malachilandis2027/Dauber/BOM.xlsx

Sheet: Mechanical Parts
Part Number/Brand | Vendor | Quantity | Description | Function | Cost Per Unit | Total Cost | Link | Received?
HoCenWay | Amazon | 1 | 5mm bore GT2 80T pulley | Attached to the 775 motor | $11.99 | $11.99 | LINK (https://www.amazon.com/Pulley-Synchronous-Wheel-Timing-Printer/dp/B08JTS1DRK?s=hi) | Yes
MOCHU | Amazon | 4 | 17mm ID, 35mm OD, angular contact, ABEC-7, bearing 7003 | Spindle bearings | $12.80 | $51.20 | LINK (https://www.amazon.com/MOCHU-7003CTYNSULP4-17x35x10-Universal-Arrangement/dp/B074PV73YV) | Yes
XunLiu | Amazon | 1 | M3 x 75mm SHCS, 10 pack | Retain eccentric tube | $7.69 | $7.69 | LINK (https://www.amazon.com/XunLiu-Socket-Screws-Wrench-Knurled/dp/B07CHMDJ3F) | Yes
uxcell | Amazon | 1 | 5mm bore x 9mm OD x 6mm length bronze bushings 6 pack | Support idler wheel | $7.49 | $7.49 | LINK (https://www.amazon.com/uxcell-Bearing-Self-Lubricating-Sintered-Bushings/dp/B07JLXF7BT) | Yes
Associated Spring Raymond | Amazon | 1 | 8mm OD x 0.7mm free height x 357N belleville discs 10 pack | Preload idler wheel | $7.69 | $7.69 | LINK (https://www.amazon.com/Belleville-Spring-millimeters-Diameter-Compressed/dp/B005Y39KZE) | Yes
uxcell | Amazon | 1 | 3mm x 30mm dowel pins 10 pack | Locate idler wheel | $5.99 | $5.99 | LINK (https://www.amazon.com/uxcell-Straight-Retaining-Stainless-Elements/dp/B01N942DIY) | Yes
uxcell | Amazon | 1 | 5mm x 20mm dowel pins 10 pack | Idler wheel shaft | $8.99 | $8.99 | LINK (https://www.amazon.com/uxcell-Stainless-Cylindrical-Support-Elements/dp/B07Y58N9Z6) | Yes
PGN | Amazon | 1 | 15mm ID, 32mm OD, bearing 6002 | Drive wheel bearing | $6.45 | $6.45 | LINK (https://www.amazon.com/PGN-6002-2RS-Sealed-Ball-Bearing/dp/B07GVR3S7K) | Yes
priaolker | Amazon | 1 | M4 x 6mm set screw, 30 pack | Affix drive wheel to stepper | $5.99 | $5.99 | LINK (https://www.amazon.com/Stainless-Socket-Screws-Hexagon-Headless/dp/B0B392V6CX) | Yes
uxcell | Amazon | 1 | M8 x 20mm set screw, ball tip, 30 pack | Preload idler wheel | $8.99 | $8.99 | LINK (https://www.amazon.com/uxcell-Screws-Carbon-Metric-Spring/dp/B0B4DF6PTM) | Yes
It Works Great | Amazon | 1 | M3 x 6mm BHCS, 100 pack | Retain drive wheel bearing | $7.99 | $7.99 | LINK (https://www.amazon.com/M3-0-5-Button-Socket-Screws-Finish/dp/B09G6L5D7B) | Yes
MewuDecor | Amazon | 1 | M5 x 12mm SHCS, 100 pack | Affix cap | $9.49 | $9.49 | LINK (https://www.amazon.com/Socket-Screws-Grade-Thread-Quantity/dp/B07NTYF2FZ) | Yes
uxcell | Amazon | 1 | M5 x 10mm x 1mm washers, 200 pack | Affix motor plate | $11.99 | $11.99 | LINK (https://www.amazon.com/uxcell-Plated-Washers-Spacers-Fastener/dp/B01NAB602N) | Yes
uxcell | Amazon | 1 | M6 x 6mm Pneumatic Fitting | Guide aluminum wire | $8.99 | $8.99 | LINK (https://www.amazon.com/uxcell-Straight-Pneumatic-Connect-Fittings/dp/B07Z9JYLMV) | Yes
CGELE | Amazon | 1 | 6mm OD x 4mm ID x 12m pneumatic tube | Guide aluminum wire | $11.99 | $11.99 | LINK (https://www.amazon.com/CGELE-Pneumatic-Tubing-39-4ft-Transfer/dp/B09JG5J24K) | Yes
MewuDecor | Amazon | 1 | M5 x 16mm SHCS, 50 pack | Affix motor plate | $8.89 | $8.89 | LINK (https://www.amazon.com/Socket-Screws-Grade-Alloy-Thread/dp/B0BLNLH7YY) | Yes
Generic | Amazon | 1 | 3mm x 12mm dowel pin 50 pack | Locate cap | $8.49 | $8.49 | LINK (https://www.amazon.com/3mm-12mm-Stainless-Support-Shelves/dp/B0BFRTZFCL) | Yes
RobotDigg | Amazon | 1 | GT2 260mm belt 10 pack | Connect 775 to spindle | $18.99 | $18.99 | LINK (https://www.amazon.com/RobotDigg-260-2gt-6-Endless-Length-Synchronous/dp/B07B5Y4MGZ) | Yes
HATCHBOX | Amazon | 1 | 1kg White PLA | Housings | $24.99 | $24.99 | LINK (https://www.amazon.com/HATCHBOX-3D-Filament-Dimensional-Accuracy/dp/B00J0GMMP6) | Yes
 |  |  |  |  |  | $0.00
 |  |  |  |  |  | $0.00
 |  |  |  |  |  | $0.00
 |  |  |  |  |  | $0.00
 |  |  |  |  |  | $0.00
 |  |  |  |  |  | $0.00
 |  |  |  |  |  | $0.00
 |  |  |  |  |  | $0.00
 |  |  |  |  |  | $0.00
 |  |  |  |  |  | $0.00
 |  |  |  |  |  | $0.00
 |  |  |  |  |  | $0.00
 |  |  |  |  |  | $0.00
 |  |  |  |  |  | $0.00
 |  |  |  |  |  | $0.00
 |  |  |  |  |  | $0.00
 |  |  |  |  |  | $0.00
 |  |  |  |  |  | $0.00
 |  |  |  |  |  | $0.00
 |  |  |  |  |  | $0.00
 |  |  |  |  |  | $0.00
 |  |  |  |  |  | $0.00
 |  |  |  |  |  | $0.00
Running Total: | $234.28

Sheet: Electrical Parts
Part Number/Brand | Vendor | Quantity | Description | Function | Cost Per Unit | Total Cost | Link | Received?
HiLetgo BTS7960 | Amazon | 1 | 43A High Power Motor Driver | Controls flow of power to the 775 main drive motor | $10.99 | $10.99 | LINK (https://www.amazon.com/HiLetgo-BTS7960-Driver-Arduino-Current/dp/B00WSN98DC?s=industrial) | Yes
CZH-LABS | Amazon | 1 | Screw Terminal Block for Arduino Nano | Breaks out the pins from the Arduino RP2040 Connect | $17.90 | $17.90 | LINK (https://www.amazon.com/CZH-LABS-Terminal-Breakout-Module-Arduino/dp/B07QMRDZ3W?s=industrial) | Yes
Meanwell LRS-350-24 | Amazon | 1 | 24V 14.6A Switchable Power Supply | Supplies power to the 775 and the stepper motor | $36.90 | $36.90 | LINK (https://www.amazon.com/MEAN-WELL-LRS-350-24-350-4W-Switchable/dp/B013ETVO12?s=industrial) | Yes
Stepperonline DM542T | Amazon | 1 | 1.0A-4.2A 20-50VDC Stepper Driver | Controls flow of power to the stepper on extruder | $21.99 | $21.99 | LINK (https://www.amazon.com/STEPPERONLINE-1-0-4-2A-20-50VDC-Micro-step-Resolutions/dp/B06Y5VPSFN) | Yes
Stepperonline | Amazon | 1 | 27:1 Nema 17 Stepper | Rotates the extruder wheels | $41.91 | $41.91 | LINK (https://www.amazon.com/27-Planetary-Gearbox-Stepper-Printer/dp/B00QEUZ9EM) | Yes
3Dman | Amazon | 1 | Power Socket | Power inlet from wall plug | $7.99 | $7.99 | LINK (https://www.amazon.com/3Dman-Rocker-Switch-Socket-C14-2pcs/dp/B07RRY5MYZ) | Yes
CERRXIAN | Amazon | 1 | Micro USB male to USB female | Takes the USB from the Arduino out to the panel | $8.79 | $8.79 | LINK (https://www.amazon.com/CERRXIAN-Female-Extension-Charge-Screws/dp/B07G4XYJ5W?s=industrial) | Yes
HiLetgo | Amazon | 1 | Logic level converter 10 pack | Shifts 3.3V to 5V for stepper controller | $7.49 | $7.49 | LINK (https://www.amazon.com/HiLetgo-Channels-Converter-Bi-Directional-3-3V-5V/dp/B07F7W91LC?s=industrial) | Yes
 |  |  |  |  |  | $0.00
 |  |  |  |  |  | $0.00
 |  |  |  |  |  | $0.00
 |  |  |  |  |  | $0.00
 |  |  |  |  |  | $0.00
 |  |  |  |  |  | $0.00
 |  |  |  |  |  | $0.00
 |  |  |  |  |  | $0.00
 |  |  |  |  |  | $0.00
 |  |  |  |  |  | $0.00
 |  |  |  |  |  | $0.00
 |  |  |  |  |  | $0.00
 |  |  |  |  |  | $0.00
 |  |  |  |  |  | $0.00
 |  |  |  |  |  | $0.00
 |  |  |  |  |  | $0.00
 |  |  |  |  |  | $0.00
 |  |  |  |  |  | $0.00
 |  |  |  |  |  | $0.00
 |  |  |  |  |  | $0.00
 |  |  |  |  |  | $0.00
 |  |  |  |  |  | $0.00
 |  |  |  |  |  | $0.00
 |  |  |  |  |  | $0.00
 |  |  |  |  |  | $0.00
 |  |  |  |  |  | $0.00
 |  |  |  |  |  | $0.00
 |  |  |  |  |  | $0.00
 |  |  |  |  |  | $0.00
 |  |  |  |  |  | $0.00
 |  |  |  |  |  | $0.00
 |  |  |  |  |  | $0.00
 |  |  |  |  |  | $0.00
 |  |  |  |  |  | $0.00
Running Total: | $153.96

Sheet: Machined Parts
Part Name | Quantity | Material |  | Quoted Price from Sinorise
Brazing Clamp 1 | 1 | Mild Steel |  | $25.00
Brazing Clamp 2 | 1 | Mild Steel |  | $25.00
Brazing Spacer | 1 | Mild Steel |  | $25.00
Cap | 1 | Carbon Steel |  | $25.00
Drive Wheel | 1 | Carbon Steel |  | $25.00
Eccentric Tube | 1 | Carbon Steel |  | $35.00
Fixed Shaft | 1 | Carbon Steel |  | $25.00
Idler Holder | 1 | Carbon Steel |  | $25.00
Idler Wheel | 1 | Carbon Steel |  | $25.00
Main Body | 1 | Carbon Steel |  | $85.00
Motor Plate | 1 | Mild Steel |  | $25.00
Nozzle | 1 | Carbon Steel |  | $30.00
Pulley Tube | 1 | Carbon Steel |  | $95.00
Retaining Ring | 1 | Carbon Steel |  | $25.00
Separation Ring | 1 | Carbon Steel |  | $25.00
Spacer Tube | 2 | Carbon Steel |  | $45.00
Wobble Shaft | 1 | Carbon Steel |  | $45.00
 |  |  | Total: | $610.00
