malachilandis2027/Dauber/CAD/Assemblies/Spindle Assembly.SLDASM

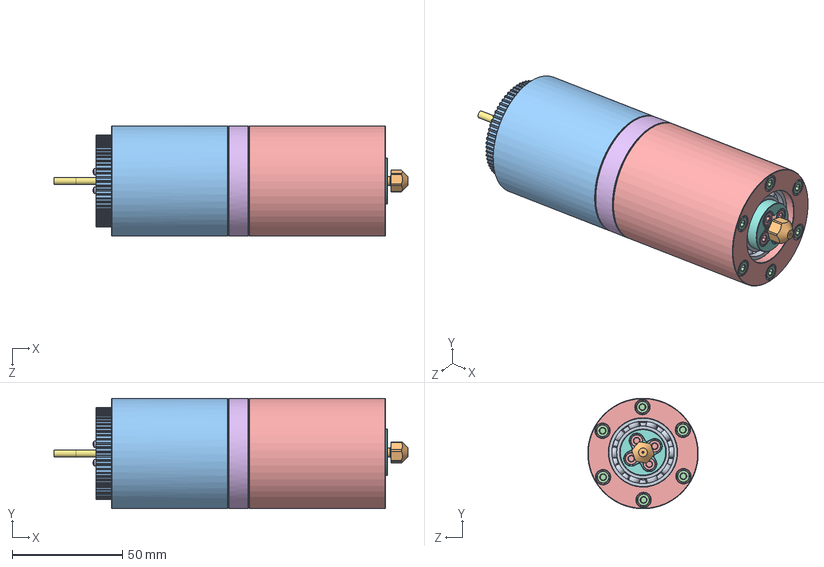
[picture p1: CAD file, 2023-07-06]
CAD/Assemblies/Spindle Assembly.SLDASM
160.2 x 50.0 x 50.0 mm
Fixed Shaft
Wobble Shaft
Pulley Tube
Spacer Tube x 2
Eccentric Tube
Separation Ring
Flexure Tube
Retaining Ring
7003 Angular Contact Bearing x 4
Nozzle
3mm x 20mm Dowel Pin x 2
M3 x 75mm x 6
M3 x 8mm SHCS x 4
3mm x 12mm Dowel Pin x 2
