malachilandis2027/Dauber/V2/CAD/V2 Assy.SLDASM

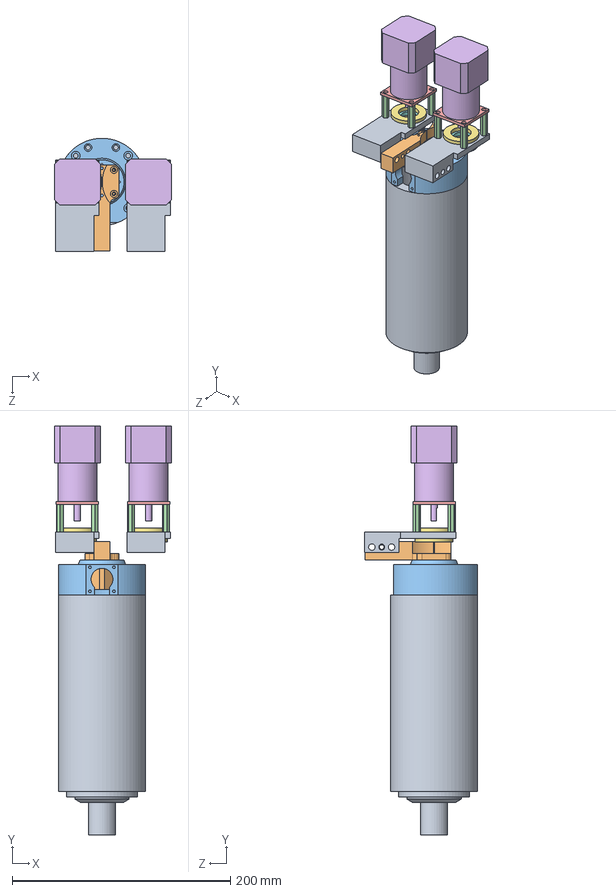
[picture p2: CAD file, 2024-10-05]
V2/CAD/V2 Assy.SLDASM
107.5 x 375.0 x 104.0 mm
Wire Guide
Motor Mount x 2
Feed Radial Bearing x 2
Feed Thrust Bearing x 4
Stepper x 2
Stepper Adapter Plate x 2
Hex Standoff M4 25mm x 8
Spindle Cap
Tube Holder Top
Spindle Body
