malachilandis2027/Dauber/V2/CAD/Rotating Assy.SLDASM

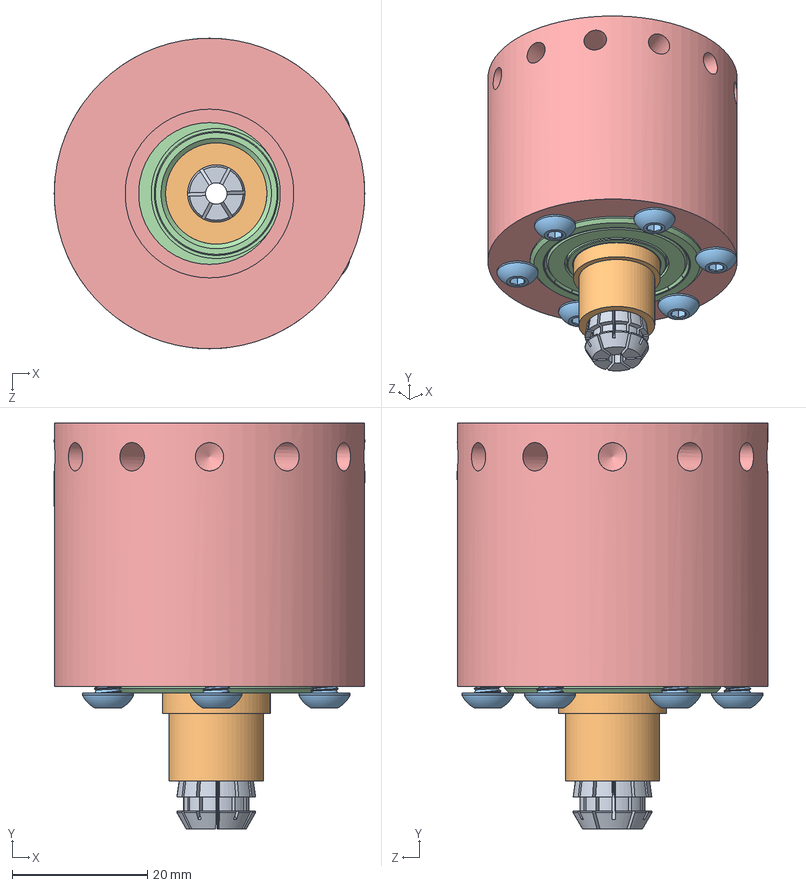
[picture p3: CAD file, 2024-03-31]
V2/CAD/Rotating Assy.SLDASM
46.0 x 60.1 x 46.0 mm
Rotating Bearing Block Straight
6002 Shielded Bearing x 2
M4 x 6mm BHCS x 6
ER11 Orbiting Collet
ER11 Collet 0.125in
