malachilandis2027/Dauber/V2/Buildplate/Lower Plate Top.DXF

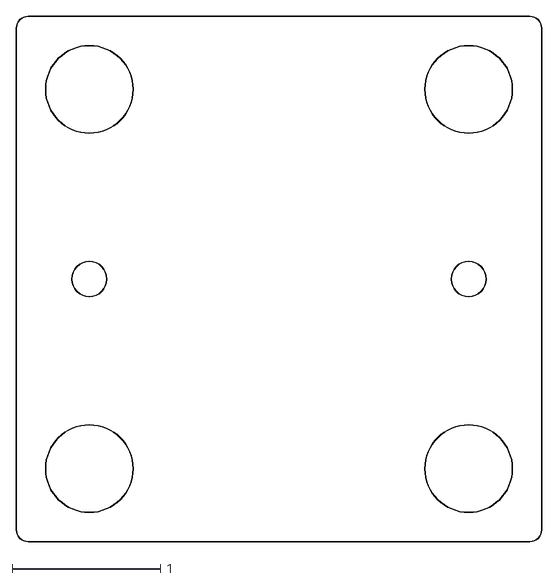
[picture p4: CAD file, 2025-02-11]
V2/Buildplate/Lower Plate Top.DXF
3.54 x 3.54
