malachilandis2027/Dauber/V2/CAD/Custom Parts/Feeder Spacer 1,0mm.STL

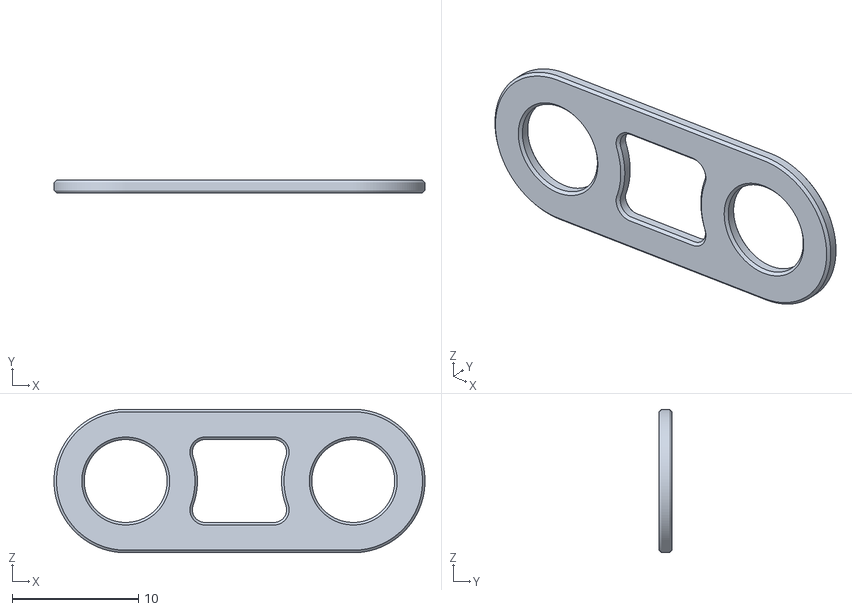
[picture p5: CAD file, 2025-01-28]
V2/CAD/Custom Parts/Feeder Spacer 1,0mm.STL
29.3 x 1.00 x 11.4
