malachilandis2027/Dauber/V2/CAD/Modified Parts/Spindle Cap.SLDPRT

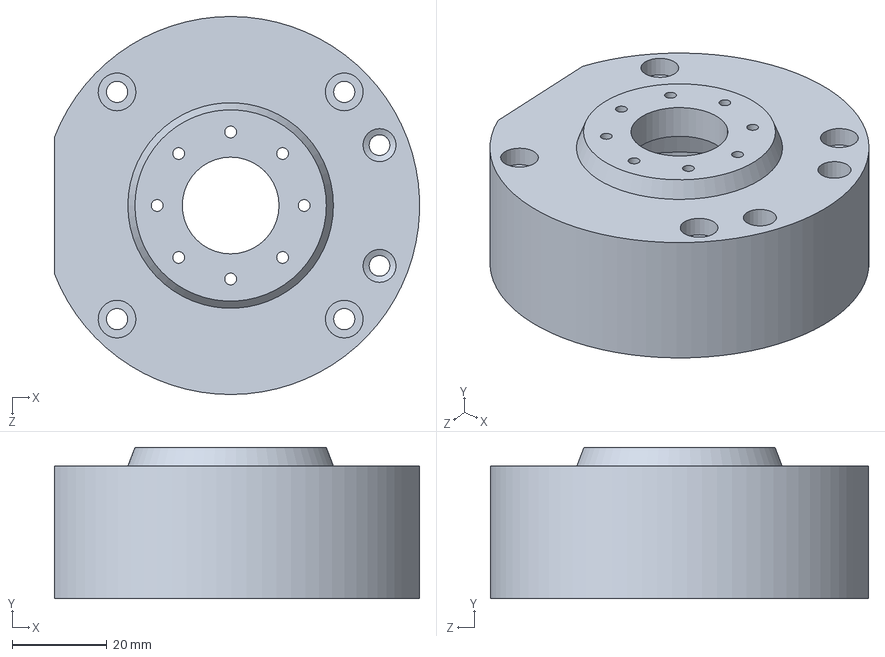
[picture p6: CAD file, 2024-09-06]
V2/CAD/Modified Parts/Spindle Cap.SLDPRT
77.2 x 32.0 x 80.0 mm
