malachilandis2027/Dauber/V2/CAD/Purchased Parts/Spindle Body.SLDPRT

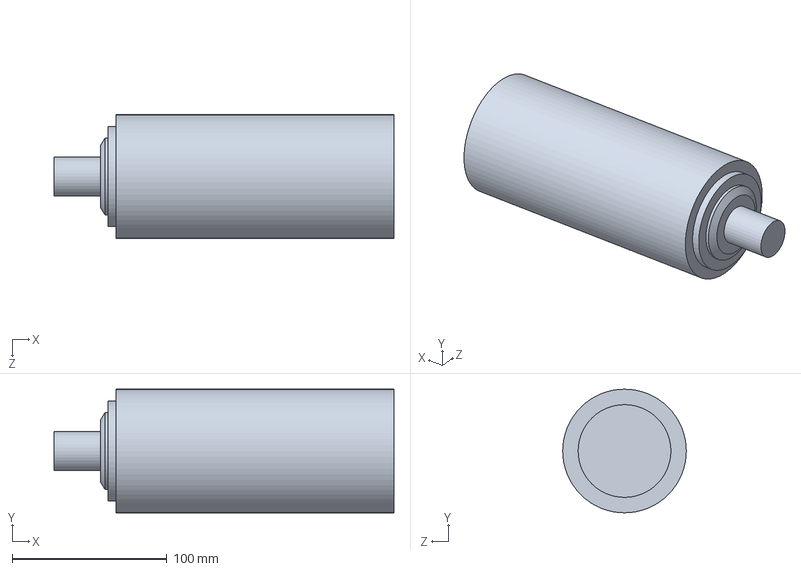
[picture p7: CAD file, 2024-09-06]
V2/CAD/Purchased Parts/Spindle Body.SLDPRT
220.0 x 80.0 x 80.0 mm
