malachilandis2027/Dauber/V2/Enclosure/Guide for Steppers PSU, Terminal Block.SLDPRT

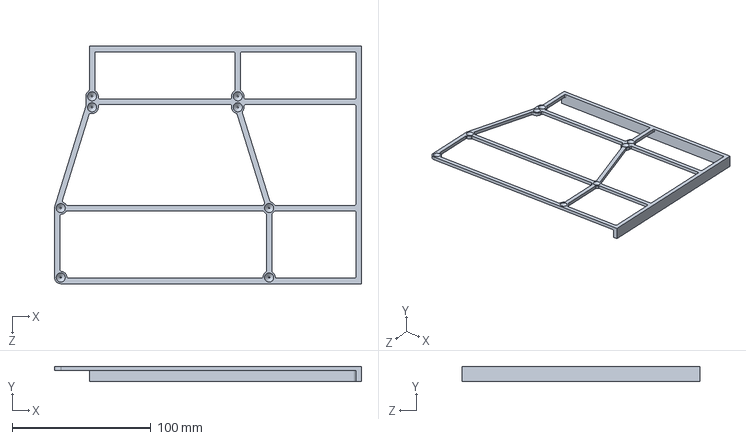
[picture p8: CAD file, 2025-01-21]
V2/Enclosure/Guide for Steppers PSU, Terminal Block.SLDPRT
221.0 x 11.0 x 171.0 mm
