malachilandis2027/Dauber/V2/Buildplate/Upper Plate Small.SLDPRT

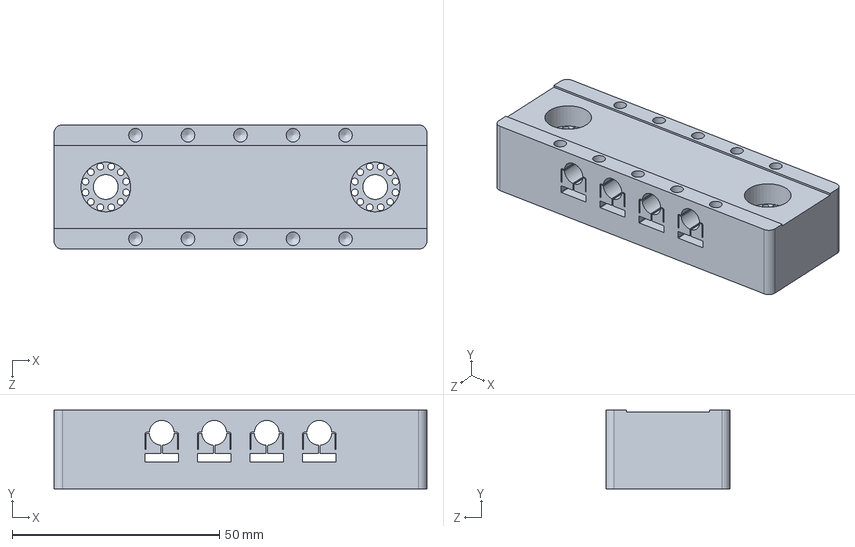
[picture p9: CAD file, 2025-02-11]
V2/Buildplate/Upper Plate Small.SLDPRT
90.0 x 19.1 x 30.0 mm
