malachilandis2027/Dauber/V2/CAD/Modified Parts/ER11 Orbiting Collet.SLDPRT

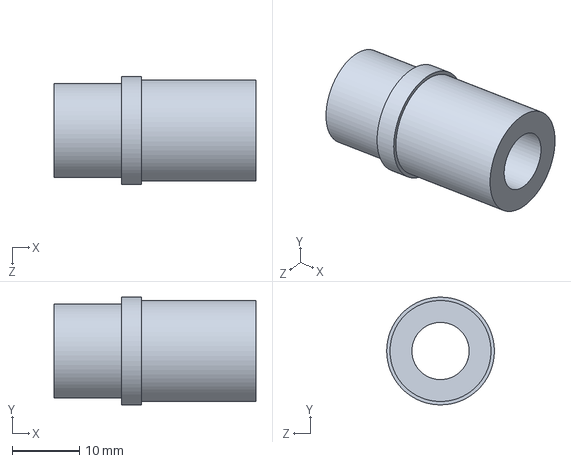
[picture p10: CAD file, 2024-03-31]
V2/CAD/Modified Parts/ER11 Orbiting Collet.SLDPRT
30.0 x 16.0 x 16.0 mm
