malachilandis2027/Dauber/V2/CAD/Purchased Parts/Hex Standoff M4 25mm.SLDPRT

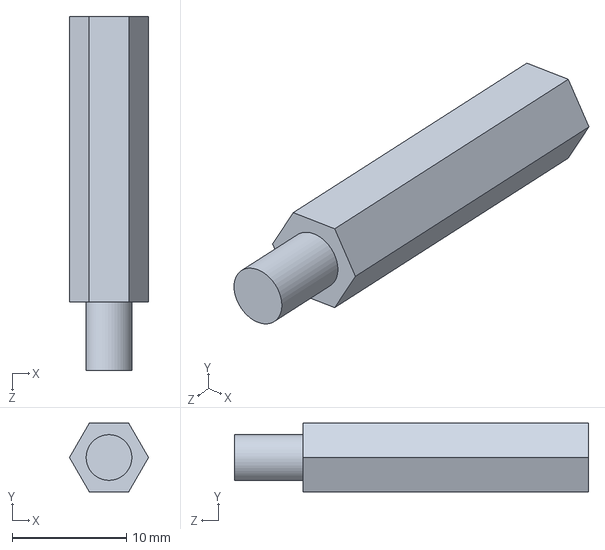
[picture p11: CAD file, 2024-09-06]
V2/CAD/Purchased Parts/Hex Standoff M4 25mm.SLDPRT
6.93 x 6.00 x 31.0 mm
