malachilandis2027/Dauber/V2/Enclosure/Top Panel.SLDPRT

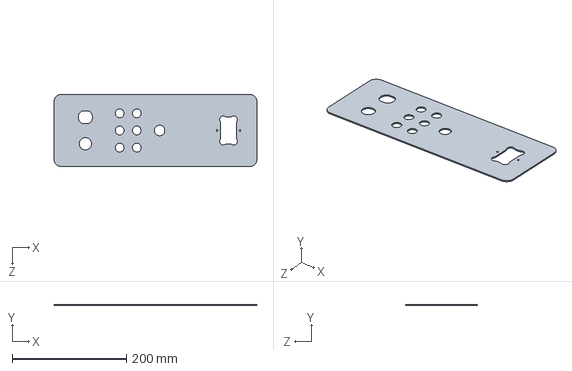
[picture p12: CAD file, 2025-01-21]
V2/Enclosure/Top Panel.SLDPRT
355.6 x 2.00 x 126.5 mm
