malachilandis2027/Dauber/V2/Buildplate/Upper Plate Underside.DXF

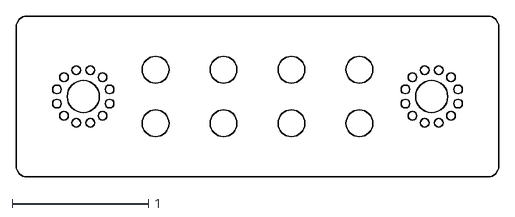
[picture p13: CAD file, 2025-02-11]
V2/Buildplate/Upper Plate Underside.DXF
3.54 x 1.18
