malachilandis2027/Dauber/V2/CAD/Purchased Parts/Feed Thrust Bearing.SLDPRT

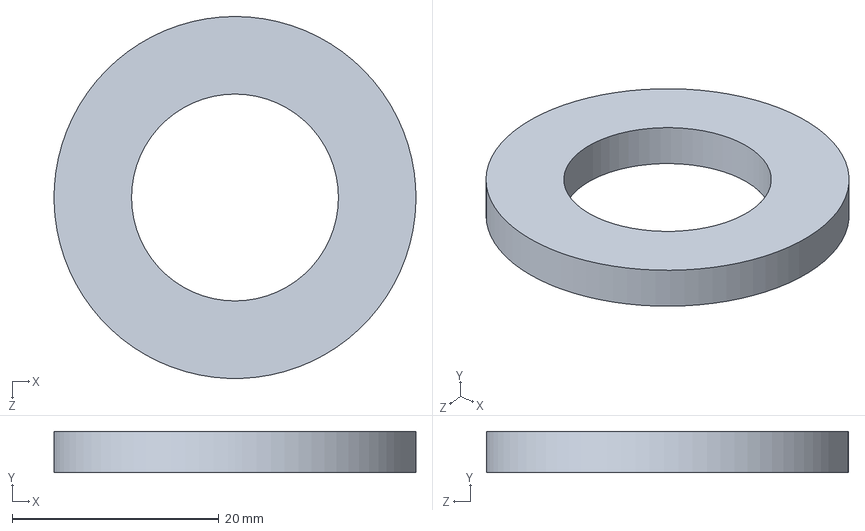
[picture p14: CAD file, 2024-09-06]
V2/CAD/Purchased Parts/Feed Thrust Bearing.SLDPRT
35.0 x 4.00 x 35.0 mm
