malachilandis2027/Dauber/V2/Enclosure/Guide for VFD, Acorn PSU.SLDPRT

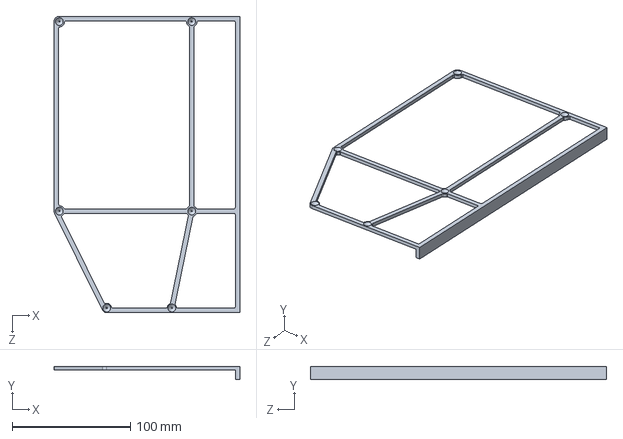
[picture p15: CAD file, 2025-01-21]
V2/Enclosure/Guide for VFD, Acorn PSU.SLDPRT
157.0 x 11.0 x 250.2 mm
