malachilandis2027/Dauber/V2/Buildplate/Upper Plate Side.DXF

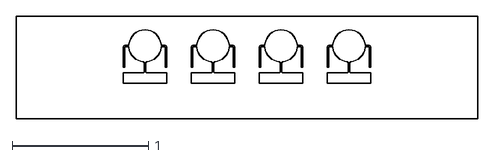
[picture p16: CAD file, 2025-02-11]
V2/Buildplate/Upper Plate Side.DXF
3.39 x 0.75
