malachilandis2027/Dauber/V2/CAD/Custom Parts/Feeder Spacer 1,2mm.STL

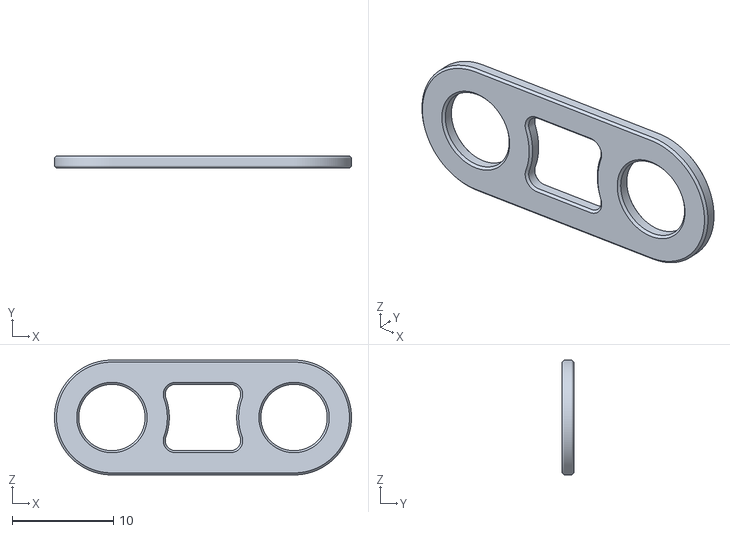
[picture p17: CAD file, 2025-01-28]
V2/CAD/Custom Parts/Feeder Spacer 1,2mm.STL
29.3 x 1.20 x 11.4
