malachilandis2027/Dauber/V2/CAD/Purchased Parts/Feed Radial Bearing.SLDPRT

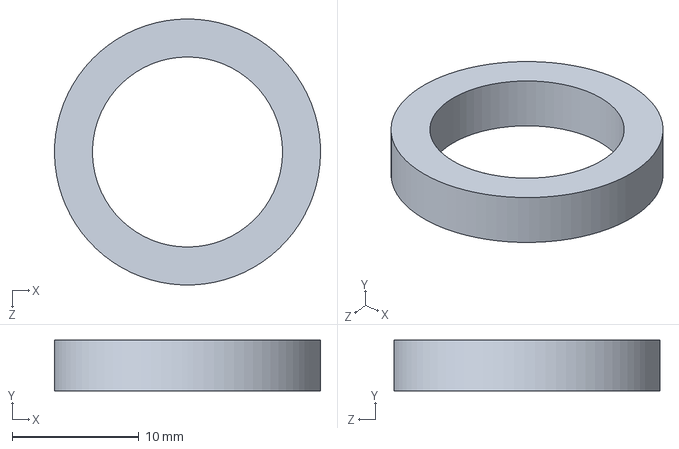
[picture p18: CAD file, 2024-09-06]
V2/CAD/Purchased Parts/Feed Radial Bearing.SLDPRT
21.0 x 4.00 x 21.0 mm
