malachilandis2027/Dauber/V2/Enclosure/Terminal Block.SLDPRT

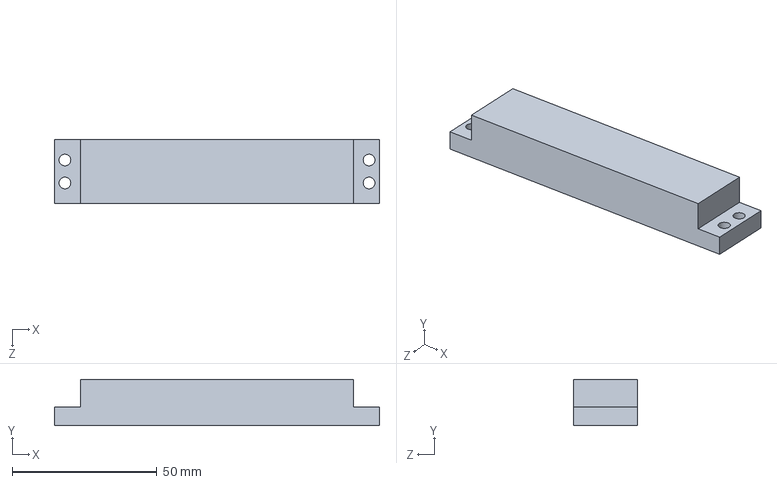
[picture p19: CAD file, 2025-01-21]
V2/Enclosure/Terminal Block.SLDPRT
112.1 x 16.0 x 22.0 mm
