malachilandis2027/Dauber/V2/Buildplate/Upper Plate.SLDPRT

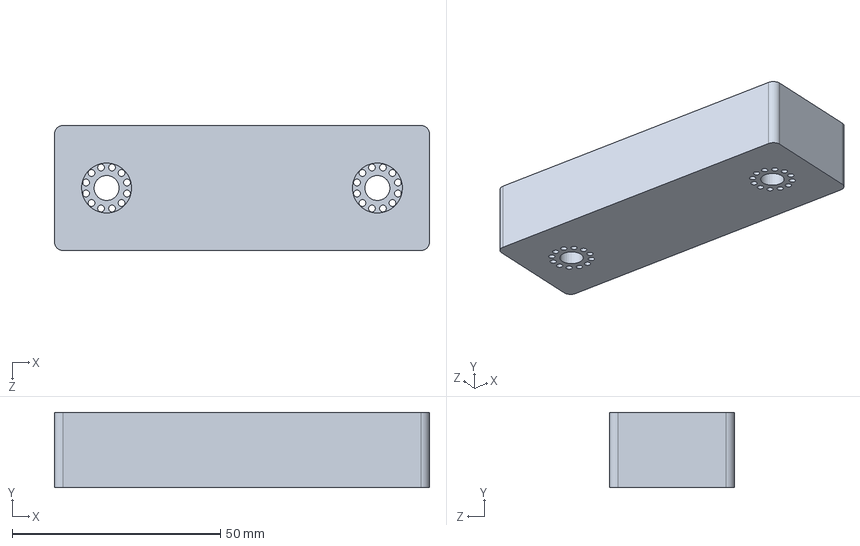
[picture p20: CAD file, 2025-02-11]
V2/Buildplate/Upper Plate.SLDPRT
90.0 x 18.0 x 30.0 mm
