malachilandis2027/Dauber/V2/CAD/Custom Parts/Feeder Spacer 0,8mm.STL

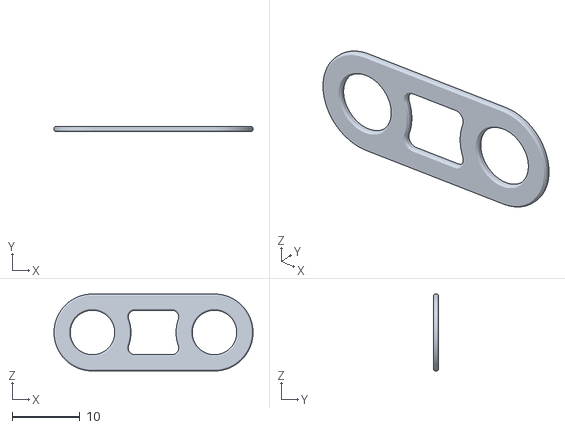
[picture p21: CAD file, 2025-01-28]
V2/CAD/Custom Parts/Feeder Spacer 0,8mm.STL
29.3 x 0.8 x 11.4
