malachilandis2027/Dauber/V2/CAD/Purchased Parts/Stepper.SLDPRT

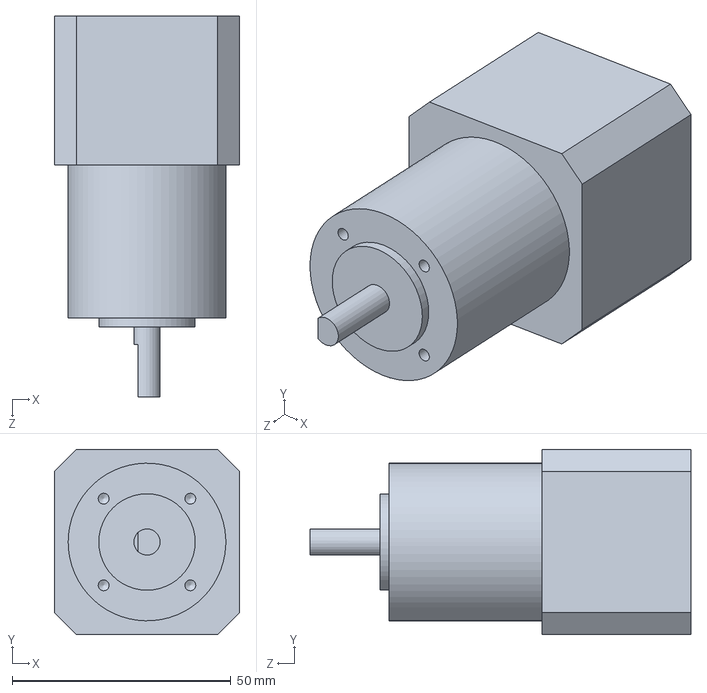
[picture p22: CAD file, 2024-09-06]
V2/CAD/Purchased Parts/Stepper.SLDPRT
42.3 x 42.3 x 87.0 mm
