malachilandis2027/Dauber/V2/Enclosure/Hole Spacer 1.SLDPRT

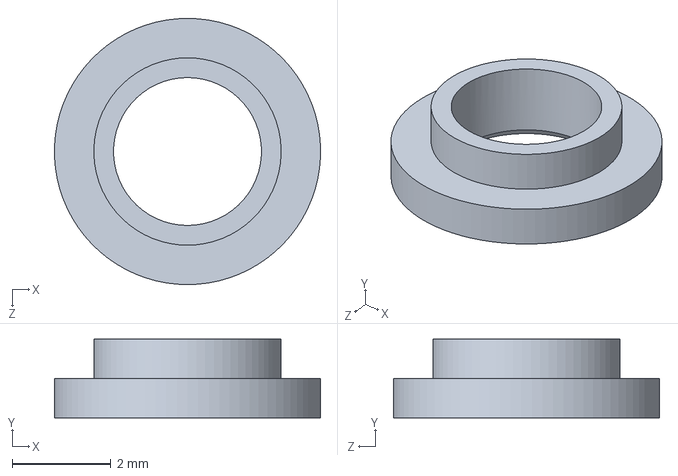
[picture p23: CAD file, 2025-01-21]
V2/Enclosure/Hole Spacer 1.SLDPRT
5.40 x 1.60 x 5.40 mm
