malachilandis2027/Dauber/V2/Buildplate/Upper Plate Large.SLDPRT

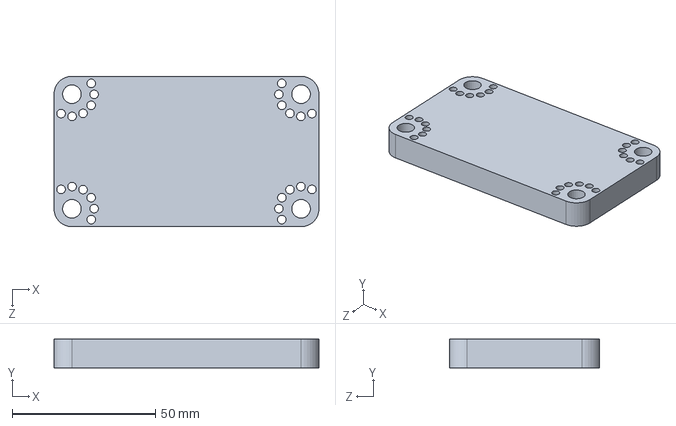
[picture p24: CAD file, 2025-02-11]
V2/Buildplate/Upper Plate Large.SLDPRT
92.5 x 10.0 x 52.5 mm
