malachilandis2027/Dauber/V2/CAD/Custom Parts/Feeder Spacer 1,4mm.STL

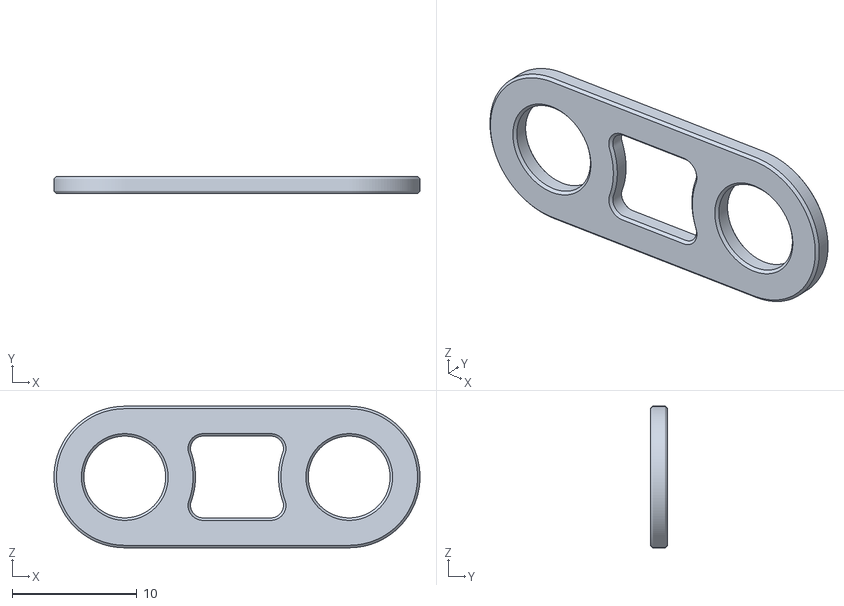
[picture p25: CAD file, 2025-01-28]
V2/CAD/Custom Parts/Feeder Spacer 1,4mm.STL
29.3 x 1.40 x 11.4
