malachilandis2027/Dauber/V2/CAD/Purchased Parts/ER11 Collet 0.125in.SLDPRT

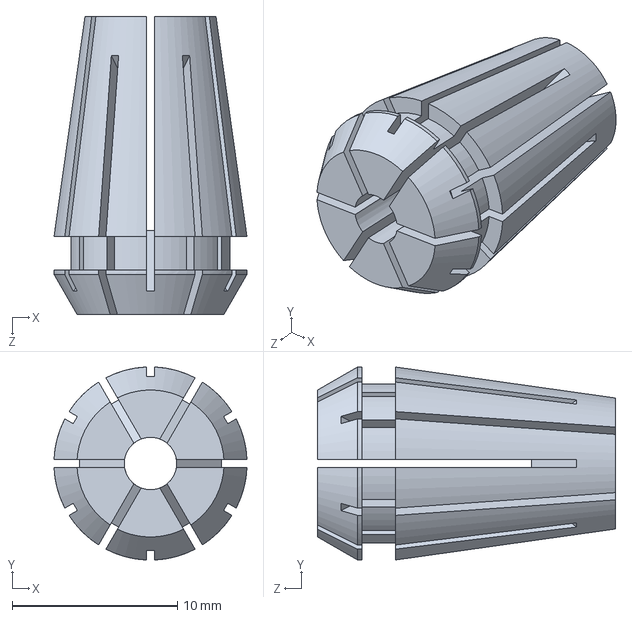
[picture p26: CAD file, 2024-03-31]
V2/CAD/Purchased Parts/ER11 Collet 0.125in.SLDPRT
11.7 x 11.7 x 18.0 mm
