malachilandis2027/Dauber/V2/Enclosure/Hole Spacer 2.SLDPRT

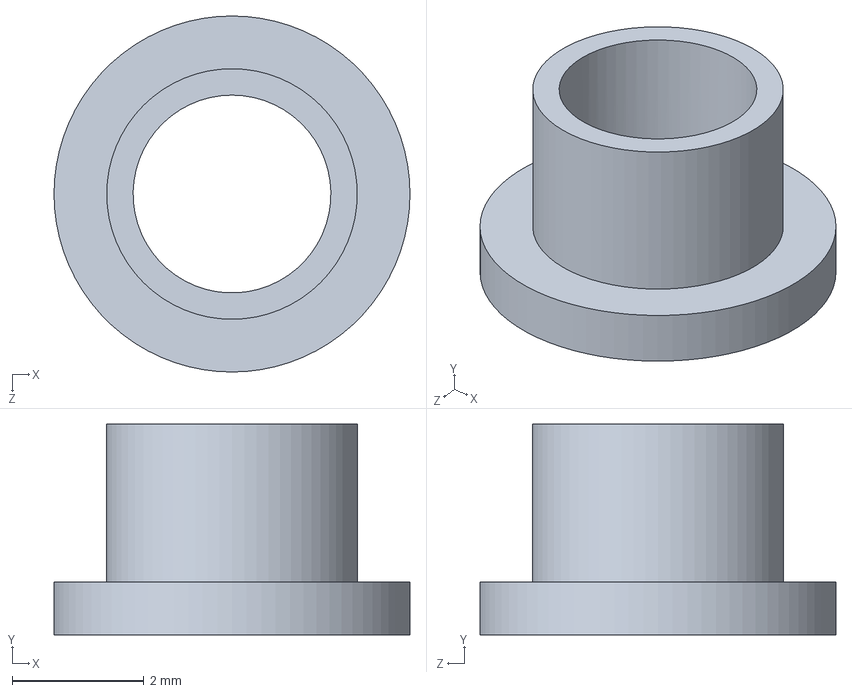
[picture p27: CAD file, 2025-01-21]
V2/Enclosure/Hole Spacer 2.SLDPRT
5.40 x 3.20 x 5.40 mm
