malachilandis2027/Dauber/V2/Buildplate/Lower Plate.SLDPRT

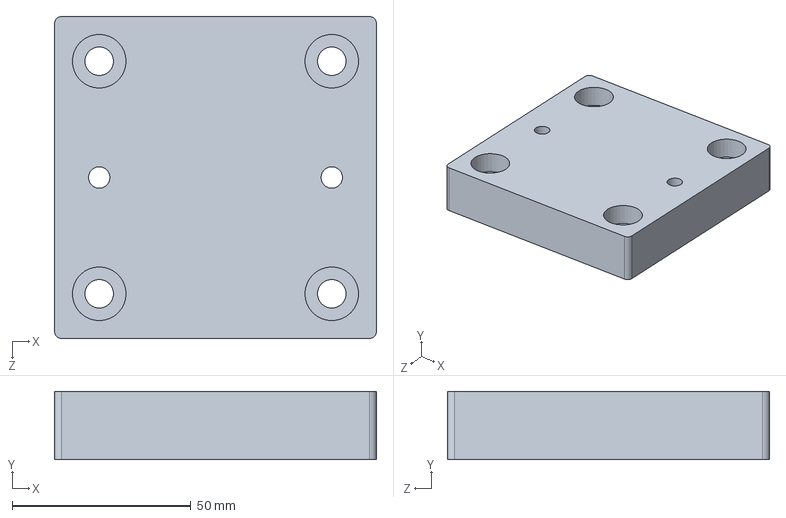
[picture p28: CAD file, 2025-02-11]
V2/Buildplate/Lower Plate.SLDPRT
90.0 x 19.1 x 90.0 mm
