malachilandis2027/Dauber/V2/CAD/Custom Parts/Wire Guide.SLDPRT

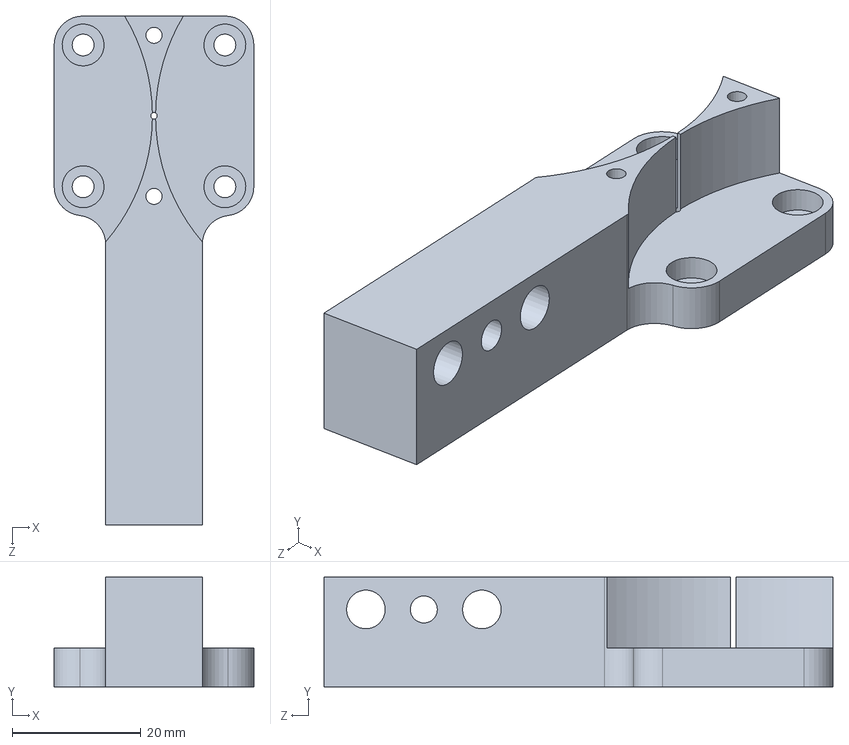
[picture p29: CAD file, 2024-10-05]
V2/CAD/Custom Parts/Wire Guide.SLDPRT
31.0 x 17.0 x 79.0 mm
