malachilandis2027/Dauber/V2/CAD/Purchased Parts/6002 Shielded Bearing.SLDPRT

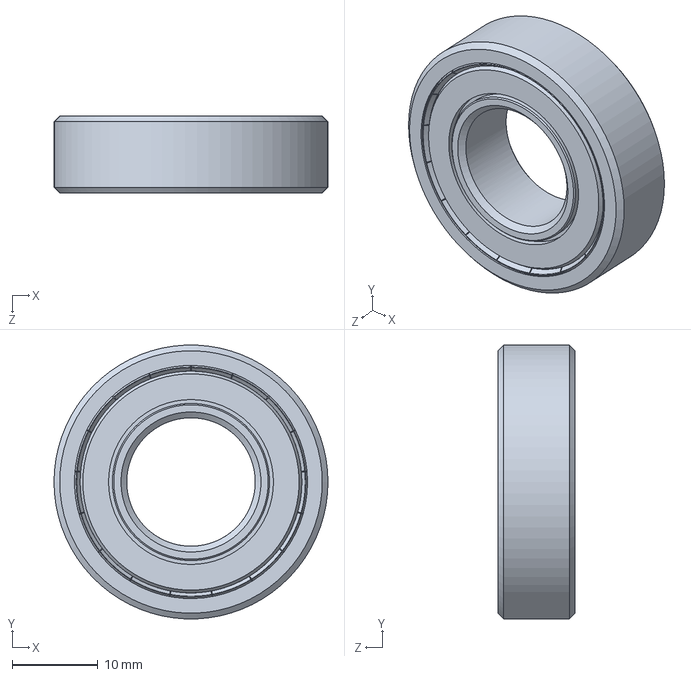
[picture p30: CAD file, 2024-03-31]
V2/CAD/Purchased Parts/6002 Shielded Bearing.SLDPRT
32.0 x 32.0 x 9.00 mm
