malachilandis2027/Dauber/V2/Enclosure/Back Panel.SLDPRT

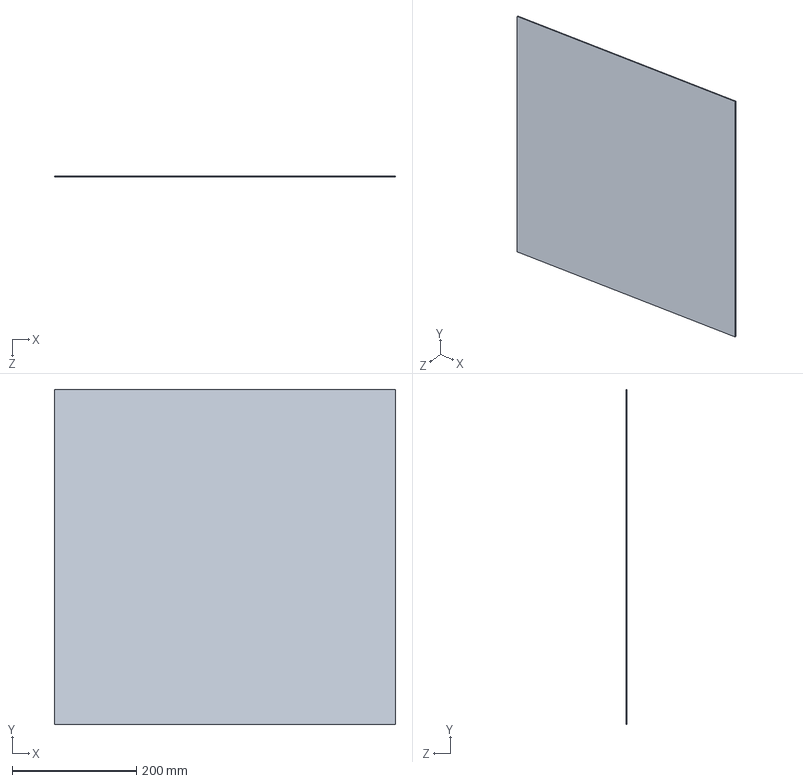
[picture p31: CAD file, 2025-01-21]
V2/Enclosure/Back Panel.SLDPRT
548.5 x 539.0 x 2.00 mm
