malachilandis2027/Dauber/V2/Enclosure/Terminal Block Riser.SLDPRT

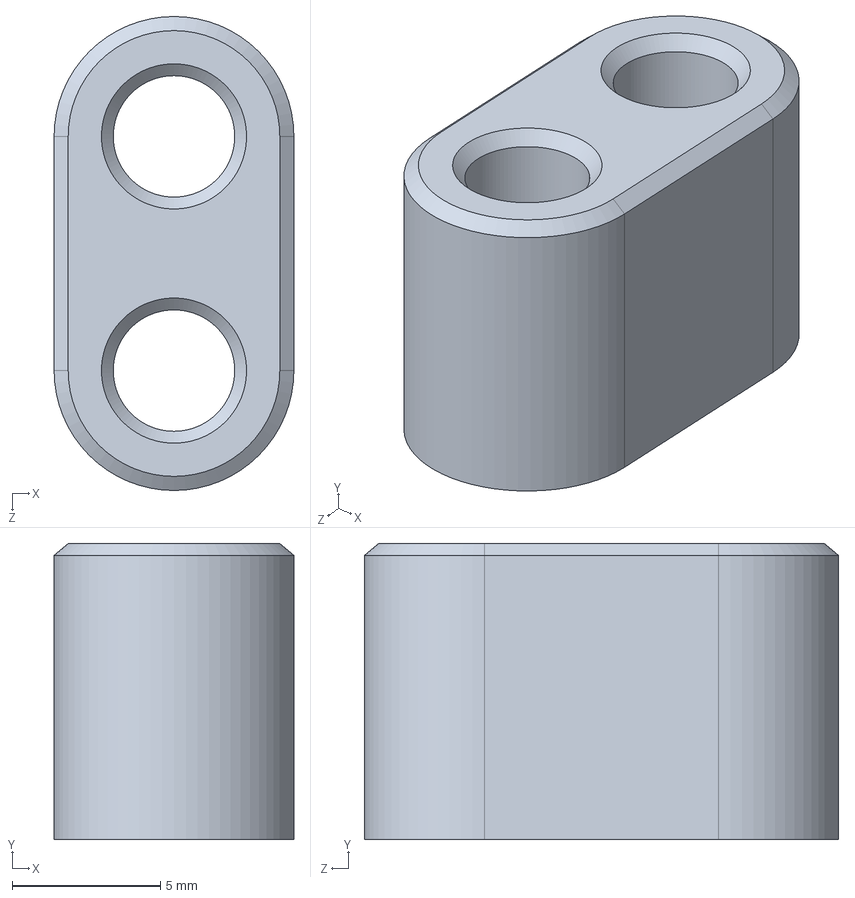
[picture p32: CAD file, 2025-01-21]
V2/Enclosure/Terminal Block Riser.SLDPRT
8.10 x 10.0 x 16.0 mm
