malachilandis2027/Dauber/V2/CAD/Custom Parts/Tube Holder Top.SLDPRT

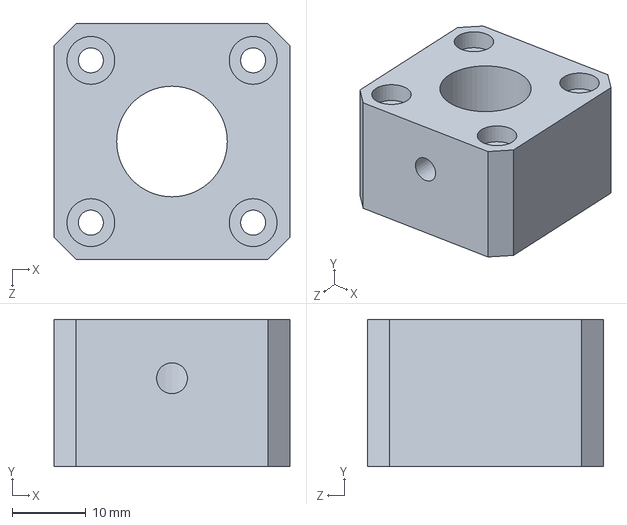
[picture p33: CAD file, 2024-09-06]
V2/CAD/Custom Parts/Tube Holder Top.SLDPRT
32.0 x 20.0 x 32.0 mm
