malachilandis2027/Dauber/V2/Enclosure/Guide for Acorn.SLDPRT

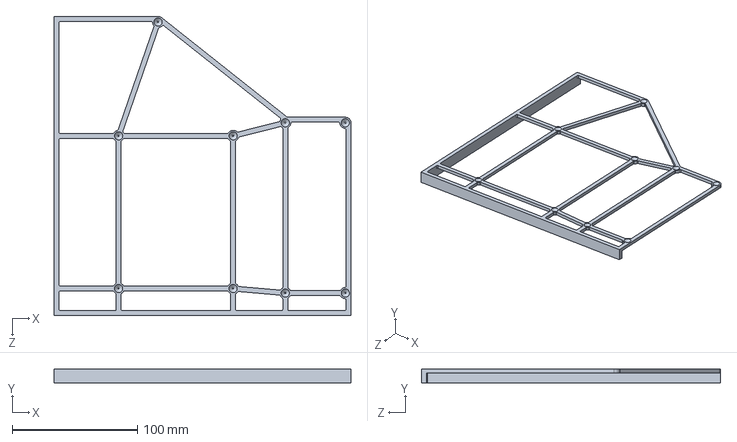
[picture p34: CAD file, 2025-01-21]
V2/Enclosure/Guide for Acorn.SLDPRT
237.2 x 11.0 x 239.0 mm
