malachilandis2027/Dauber/V2/CAD/Custom Parts/Stepper Adapter Plate.SLDPRT

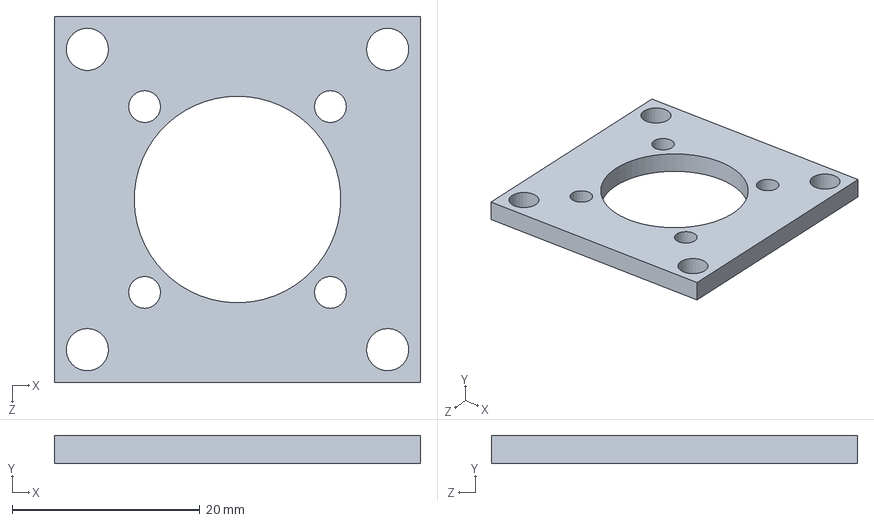
[picture p35: CAD file, 2024-09-06]
V2/CAD/Custom Parts/Stepper Adapter Plate.SLDPRT
39.0 x 3.00 x 39.0 mm
