malachilandis2027/Dauber/V2/CAD/Purchased Parts/M4 x 6mm BHCS.SLDPRT

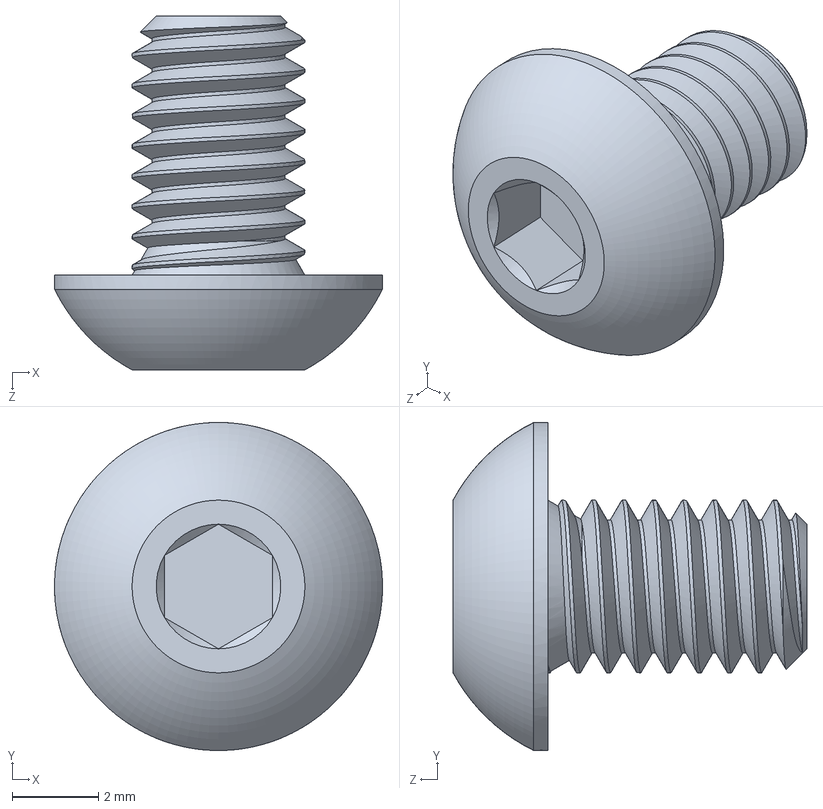
[picture p36: CAD file, 2024-03-31]
V2/CAD/Purchased Parts/M4 x 6mm BHCS.SLDPRT
7.60 x 7.60 x 8.20 mm
