malachilandis2027/Dauber/V2/Enclosure/Hole Spacer 3.SLDPRT

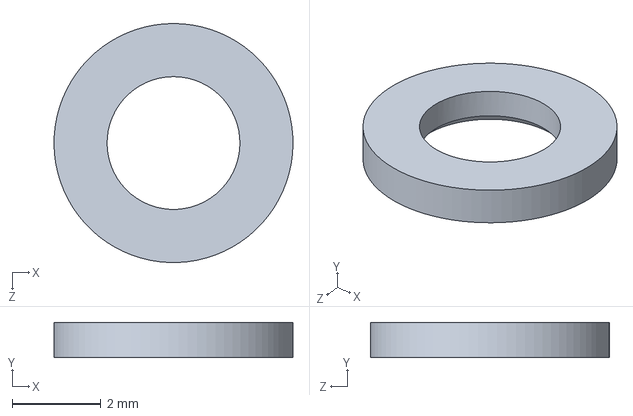
[picture p37: CAD file, 2025-01-21]
V2/Enclosure/Hole Spacer 3.SLDPRT
5.40 x 0.8 x 5.40 mm
