malachilandis2027/Dauber/V2/Enclosure/Guide for Stepppers, Terminal Block.SLDPRT

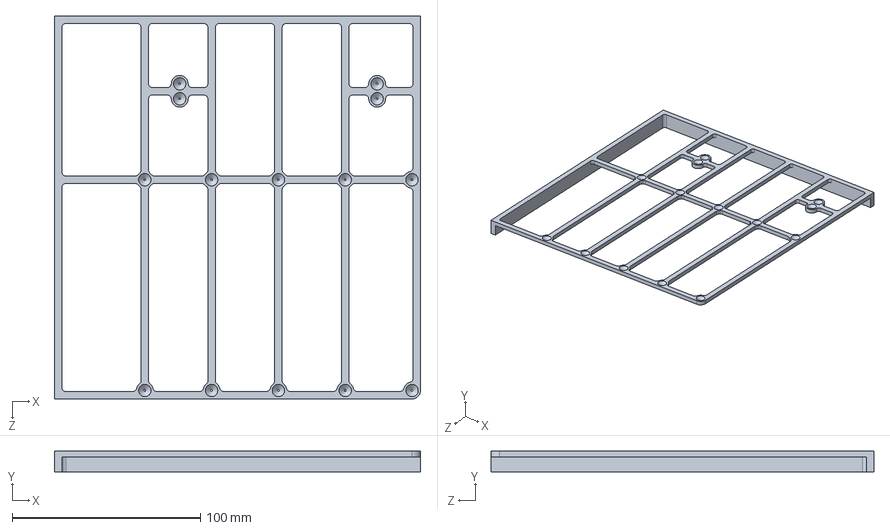
[picture p38: CAD file, 2025-01-21]
V2/Enclosure/Guide for Stepppers, Terminal Block.SLDPRT
194.5 x 11.0 x 203.5 mm
