malachilandis2027/Dauber/V2/CAD/Custom Parts/Motor Mount.SLDPRT

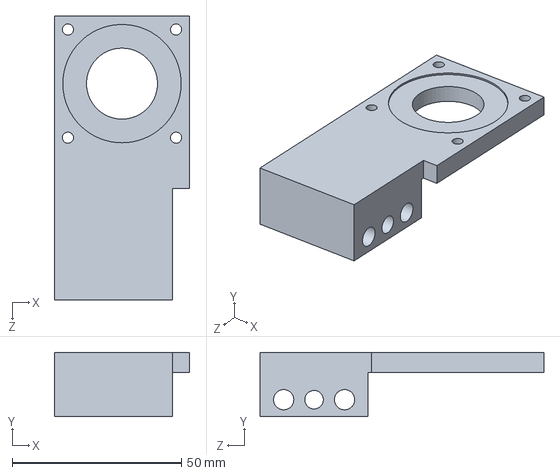
[picture p39: CAD file, 2024-09-06]
V2/CAD/Custom Parts/Motor Mount.SLDPRT
40.0 x 19.0 x 84.0 mm
