malachilandis2027/Dauber/V2/CAD/Custom Parts/Rotating Bearing Block.SLDPRT

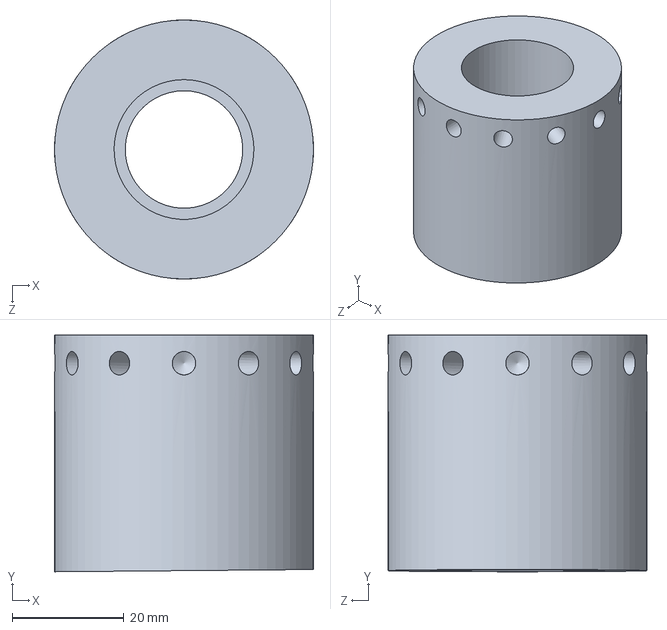
[picture p40: CAD file, 2024-03-31]
V2/CAD/Custom Parts/Rotating Bearing Block.SLDPRT
46.3 x 42.3 x 46.3 mm
