malachilandis2027/Dauber/V2/CAD/Custom Parts/ER11 Socket.SLDPRT

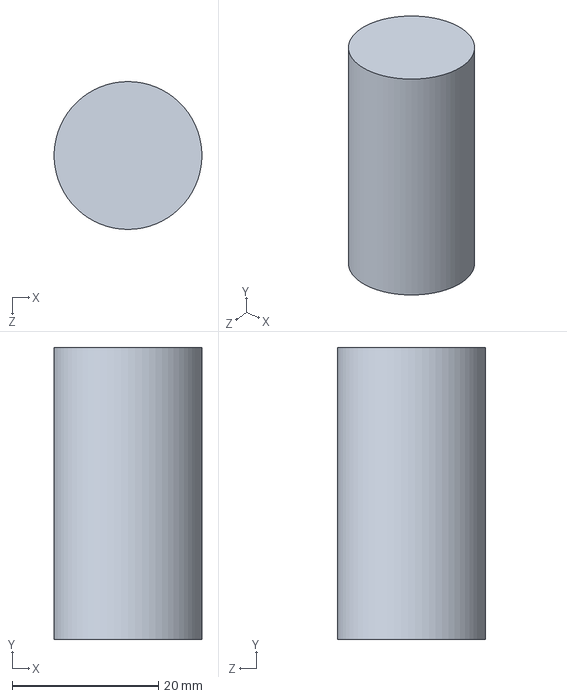
[picture p41: CAD file, 2024-03-31]
V2/CAD/Custom Parts/ER11 Socket.SLDPRT
20.2 x 40.0 x 20.2 mm
