malachilandis2027/Dauber/V2/CAD/Custom Parts/Rotating Bearing Block Straight.SLDPRT

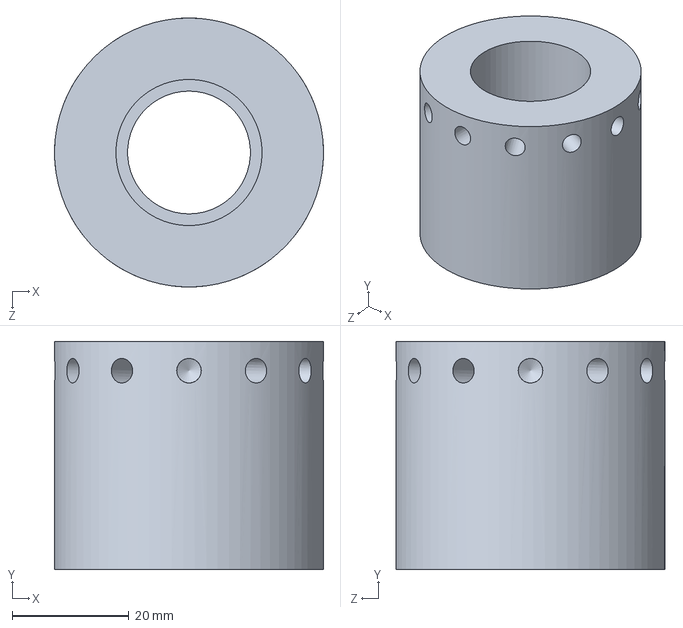
[picture p42: CAD file, 2024-03-31]
V2/CAD/Custom Parts/Rotating Bearing Block Straight.SLDPRT
46.0 x 39.0 x 46.0 mm
