malachilandis2027/Dauber/(list of files, cad)

Other CAD files:
V2/Enclosure/Back Panel Assy.SLDASM
V2/CAD/Custom Parts/Feeder Spacer 1,6mm.STL
V2/CAD/Master Sketch.SLDPRT
V2/CAD/Custom Parts/Feeder Spacer.SLDPRT
V2/CAD/Purchased Parts/ER11 Collet 0.125.SLDPRT
V2/CAD/Purchased Parts/ER11 Collet Body.SLDPRT
V1/3D Printed Feeder Demo/Assy.SLDASM
V1/3D Printed Feeder Demo/Connector.SLDPRT
V1/3D Printed Feeder Demo/Gear.SLDPRT
V1/3D Printed Feeder Demo/LH Screw.SLDPRT
V1/3D Printed Feeder Demo/RH Screw.SLDPRT
V1/3D Printed Feeder Demo/Rib.SLDPRT
V1/3D Printed Feeder Demo/STLs/Connector.STL
V1/3D Printed Feeder Demo/STLs/Gear.STL
V1/3D Printed Feeder Demo/STLs/LH Screw.STL
V1/3D Printed Feeder Demo/STLs/RH Screw.STL
V1/3D Printed Feeder Demo/STLs/Rib.STL
V1/CAD/Assemblies/Brazing Assembly.SLDASM
V1/CAD/Assemblies/Workpiece Clamp.SLDASM
V1/CAD/Drawings/Brazing Clamp 1.SLDDRW
V1/CAD/Drawings/Brazing Clamp 2.SLDDRW
V1/CAD/Drawings/Brazing Spacer.SLDDRW
V1/CAD/Drawings/Cap.SLDDRW
V1/CAD/Drawings/Drawing Template.SLDDRW
V1/CAD/Drawings/Drive Wheel MOD.SLDDRW
V1/CAD/Drawings/Drive Wheel.SLDDRW
V1/CAD/Drawings/Eccentric Tube.SLDDRW
V1/CAD/Drawings/Fixed Shaft.SLDDRW
V1/CAD/Drawings/Flexure Tube.SLDDRW
V1/CAD/Drawings/Idler Holder.SLDDRW
V1/CAD/Drawings/Idler Wheel.SLDDRW
V1/CAD/Drawings/Main Body MOD.SLDDRW
V1/CAD/Drawings/Main Body.SLDDRW
V1/CAD/Drawings/Motor Plate.SLDDRW
V1/CAD/Drawings/Nozzle.SLDDRW
V1/CAD/Drawings/Pulley Tube.SLDDRW
V1/CAD/Drawings/Retaining Ring.SLDDRW
V1/CAD/Drawings/Separation Ring.SLDDRW
V1/CAD/Drawings/Spacer Tube.SLDDRW
V1/CAD/Drawings/Spindle Assembly.SLDDRW
V1/CAD/Drawings/Teeth MOD.SLDDRW
V1/CAD/Drawings/Wobble Shaft.SLDDRW
V1/CAD/Drawings/Workpiece Clamp Base.SLDDRW
V1/CAD/Drawings/Workpiece Clamp Top.SLDDRW
V1/CAD/Drawings/Z Axis Plate MOD.SLDDRW
V1/CAD/Imported Parts/Amazon/3mm x 12mm Dowel Pin.SLDPRT
V1/CAD/Imported Parts/Amazon/3mm x 20mm Dowel Pin.SLDPRT
V1/CAD/Imported Parts/Amazon/3mm x 30mm Dowel Pin.SLDPRT
V1/CAD/Imported Parts/Amazon/5mm x 20mm Dowel Pin.SLDPRT
V1/CAD/Imported Parts/Amazon/6002 Ball Bearing.SLDPRT
V1/CAD/Imported Parts/Amazon/7003 Angular Contact Bearing.SLDPRT
V1/CAD/Imported Parts/Amazon/8mm OD x 3.2mm ID Belleville Disc Spring.SLDPRT
V1/CAD/Imported Parts/Amazon/Bronze Bushing.SLDPRT
V1/CAD/Imported Parts/Amazon/M3 x 14mm SHCS.SLDPRT
V1/CAD/Imported Parts/Amazon/M3 x 6mm BHS.SLDPRT
V1/CAD/Imported Parts/Amazon/M3 x 75mm.SLDPRT
V1/CAD/Imported Parts/Amazon/M3 x 8mm SHCS.SLDPRT
V1/CAD/Imported Parts/Amazon/M3 x 8mm.SLDPRT
V1/CAD/Imported Parts/Amazon/M4 x 6mm Set Screw.SLDPRT
V1/CAD/Imported Parts/Amazon/M5 x 10mm Washer.SLDPRT
V1/CAD/Imported Parts/Amazon/M5 x 12mm SHCS.SLDPRT
V1/CAD/Imported Parts/Amazon/M5 x 16mm SHCS.SLDPRT
V1/CAD/Imported Parts/Amazon/M6 x 0.25 Pneumatic Fitting.SLDPRT
V1/CAD/Imported Parts/Amazon/M8 x 20mm Set Screw.SLDPRT
V1/CAD/Imported Parts/Amazon/Timing Pulley.SLDPRT
V1/CAD/Imported Parts/McMaster-Carr/2333N145_Nickel-Plated Brass Push-to-Connect Fitting.SLDPRT
V1/CAD/Imported Parts/McMaster-Carr/2385K43_Angular-Contact Ball Bearing.SLDPRT
V1/CAD/Imported Parts/McMaster-Carr/2385K44_Angular-Contact Ball Bearing.SLDPRT
V1/CAD/Imported Parts/McMaster-Carr/5972K358_Ball Bearing.SLDPRT
V1/CAD/Imported Parts/McMaster-Carr/6658K66_Oil-Embedded 841 Bronze Sleeve Bearing.SLDPRT
V1/CAD/Imported Parts/McMaster-Carr/91239A111_Button Head Hex Drive Screw.SLDPRT
V1/CAD/Imported Parts/McMaster-Carr/91290A113_Alloy Steel Socket Head Screw.SLDPRT
V1/CAD/Imported Parts/McMaster-Carr/91290A119_Alloy Steel Socket Head Screw.SLDPRT
V1/CAD/Imported Parts/McMaster-Carr/91290A228_Alloy Steel Socket Head Screw.SLDPRT
V1/CAD/Imported Parts/McMaster-Carr/91290A232_Alloy Steel Socket Head Screw.SLDPRT
V1/CAD/Imported Parts/McMaster-Carr/91290A297_Alloy Steel Socket Head Screw.SLDPRT
V1/CAD/Imported Parts/McMaster-Carr/91390A112_Alloy Steel Cup-Point Set Screw.SLDPRT
V1/CAD/Imported Parts/McMaster-Carr/91390A145_Alloy Steel Cup-Point Set Screw.SLDPRT
V1/CAD/Imported Parts/McMaster-Carr/91595A112_Dowel Pin.SLDPRT
V1/CAD/Imported Parts/McMaster-Carr/91595A122_Dowel Pin.SLDPRT
V1/CAD/Imported Parts/McMaster-Carr/91595A134_Dowel Pin.SLDPRT
V1/CAD/Imported Parts/McMaster-Carr/91595A356_Dowel Pin.SLDPRT
V1/CAD/Imported Parts/McMaster-Carr/96445K173_Belleville Disc Spring.SLDPRT
V1/CAD/Imported Parts/McMaster-Carr/98269A440_Black-Oxide 18-8 Stainless Steel Washer.SLDPRT
V1/CAD/Imported Parts/Motor - RS-775.SLDPRT
V1/CAD/Imported Parts/Stepper.SLDPRT
V1/CAD/Part Exports/IGES/Brazing Clamp 1.IGS
V1/CAD/Part Exports/IGES/Brazing Clamp 2.IGS
V1/CAD/Part Exports/IGES/Brazing Spacer.IGS
V1/CAD/Part Exports/IGES/Cap.IGS
V1/CAD/Part Exports/IGES/Drive Wheel.IGS
V1/CAD/Part Exports/IGES/Eccentric Tube.IGS
V1/CAD/Part Exports/IGES/Fixed Shaft.IGS
V1/CAD/Part Exports/IGES/Idler Holder.IGS
V1/CAD/Part Exports/IGES/Idler Wheel.IGS
V1/CAD/Part Exports/IGES/Main Body.IGS
V1/CAD/Part Exports/IGES/Motor Plate.IGS
V1/CAD/Part Exports/IGES/Nozzle.IGS
V1/CAD/Part Exports/IGES/Retaining Ring.IGS
V1/CAD/Part Exports/IGES/Separation Ring.IGS
V1/CAD/Part Exports/IGES/Spacer Tube.IGS
V1/CAD/Part Exports/IGES/Wobble Shaft.IGS
V1/CAD/Part Exports/STEP/Brazing Clamp 1.STEP
V1/CAD/Part Exports/STEP/Brazing Clamp 2.STEP
V1/CAD/Part Exports/STEP/Brazing Spacer.STEP
V1/CAD/Part Exports/STEP/Cap.STEP
V1/CAD/Part Exports/STEP/Drive Wheel.STEP
V1/CAD/Part Exports/STEP/Eccentric Tube.STEP
V1/CAD/Part Exports/STEP/Fixed Shaft.STEP
V1/CAD/Part Exports/STEP/Idler Holder.STEP
V1/CAD/Part Exports/STEP/Idler Wheel.STEP
V1/CAD/Part Exports/STEP/Main Body.STEP
V1/CAD/Part Exports/STEP/Motor Plate.STEP
V1/CAD/Part Exports/STEP/Nozzle.STEP
V1/CAD/Part Exports/STEP/Pulley Tube.STEP
V1/CAD/Part Exports/STEP/Retaining Ring.STEP
V1/CAD/Part Exports/STEP/Separation Ring.STEP
V1/CAD/Part Exports/STEP/Spacer Tube.STEP
V1/CAD/Part Exports/STEP/Wobble Shaft.STEP
V1/CAD/Part Exports/STL/Pneumatic Fitting Strain Relief.STL
V1/CAD/Part Exports/STL/Press Tube.STL
V1/CAD/Part Exports/STL/Spool Holder.STL
V1/CAD/Part Exports/STL/Spool Retainer.STL
V1/CAD/Parts/Aluminum Sample.SLDPRT
V1/CAD/Parts/Anti-Rotation Clamp.SLDPRT
V1/CAD/Parts/Belt.SLDPRT
V1/CAD/Parts/Body Master Sketch.SLDPRT
V1/CAD/Parts/Brazing Clamp 1.SLDPRT
V1/CAD/Parts/Brazing Clamp 2.SLDPRT
V1/CAD/Parts/Brazing Spacer.SLDPRT
V1/CAD/Parts/Cap.SLDPRT
V1/CAD/Parts/Drive Wheel MOD.SLDPRT
V1/CAD/Parts/Drive Wheel.SLDPRT
V1/CAD/Parts/Eccentric Tube.SLDPRT
V1/CAD/Parts/Fixed Shaft.SLDPRT
V1/CAD/Parts/Flexure Tube.SLDPRT
V1/CAD/Parts/Front Shroud.SLDPRT
V1/CAD/Parts/Idler Holder.SLDPRT
V1/CAD/Parts/Idler Wheel.SLDPRT
V1/CAD/Parts/Main Body MOD.SLDPRT
V1/CAD/Parts/Main Body.SLDPRT
V1/CAD/Parts/Master Sketch.SLDPRT
V1/CAD/Parts/Motor Plate.SLDPRT
V1/CAD/Parts/Nozzle.SLDPRT
V1/CAD/Parts/Pneumatic Fitting Strain Relief.SLDPRT
V1/CAD/Parts/Press Tube.SLDPRT
V1/CAD/Parts/Pulley Tube.SLDPRT
V1/CAD/Parts/Rear Shroud.SLDPRT
V1/CAD/Parts/Retaining Ring.SLDPRT
V1/CAD/Parts/Separation Ring.SLDPRT
V1/CAD/Parts/Spacer Tube.SLDPRT
V1/CAD/Parts/Spindle Master Sketch.SLDPRT
V1/CAD/Parts/Spool Holder.SLDPRT
V1/CAD/Parts/Spool Retainer.SLDPRT
V1/CAD/Parts/Teeth MOD.SLDPRT
V1/CAD/Parts/Wobble Shaft.SLDPRT
V1/CAD/Parts/Workpiece Clamp Base.SLDPRT
V1/CAD/Parts/Workpiece Clamp Top.SLDPRT
V1/CAD/Parts/Z Axis Plate MOD.SLDPRT
V1/CAD/Requests for Quote/Malachi Landis RFQ 1/3D Model STEP/Brazing Clamp 1.STEP
V1/CAD/Requests for Quote/Malachi Landis RFQ 1/3D Model STEP/Brazing Clamp 2.STEP
V1/CAD/Requests for Quote/Malachi Landis RFQ 1/3D Model STEP/Brazing Spacer.STEP
V1/CAD/Requests for Quote/Malachi Landis RFQ 1/3D Model STEP/Cap.STEP
V1/CAD/Requests for Quote/Malachi Landis RFQ 1/3D Model STEP/Drive Wheel.STEP
V1/CAD/Requests for Quote/Malachi Landis RFQ 1/3D Model STEP/Eccentric Tube.STEP
V1/CAD/Requests for Quote/Malachi Landis RFQ 1/3D Model STEP/Fixed Shaft.STEP
V1/CAD/Requests for Quote/Malachi Landis RFQ 1/3D Model STEP/Idler Holder.STEP
V1/CAD/Requests for Quote/Malachi Landis RFQ 1/3D Model STEP/Idler Wheel.STEP
V1/CAD/Requests for Quote/Malachi Landis RFQ 1/3D Model STEP/Main Body.STEP
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
