malachilandis2027/Dauber/V1/CAD/Drawing Exports/Idler Wheel.pdf

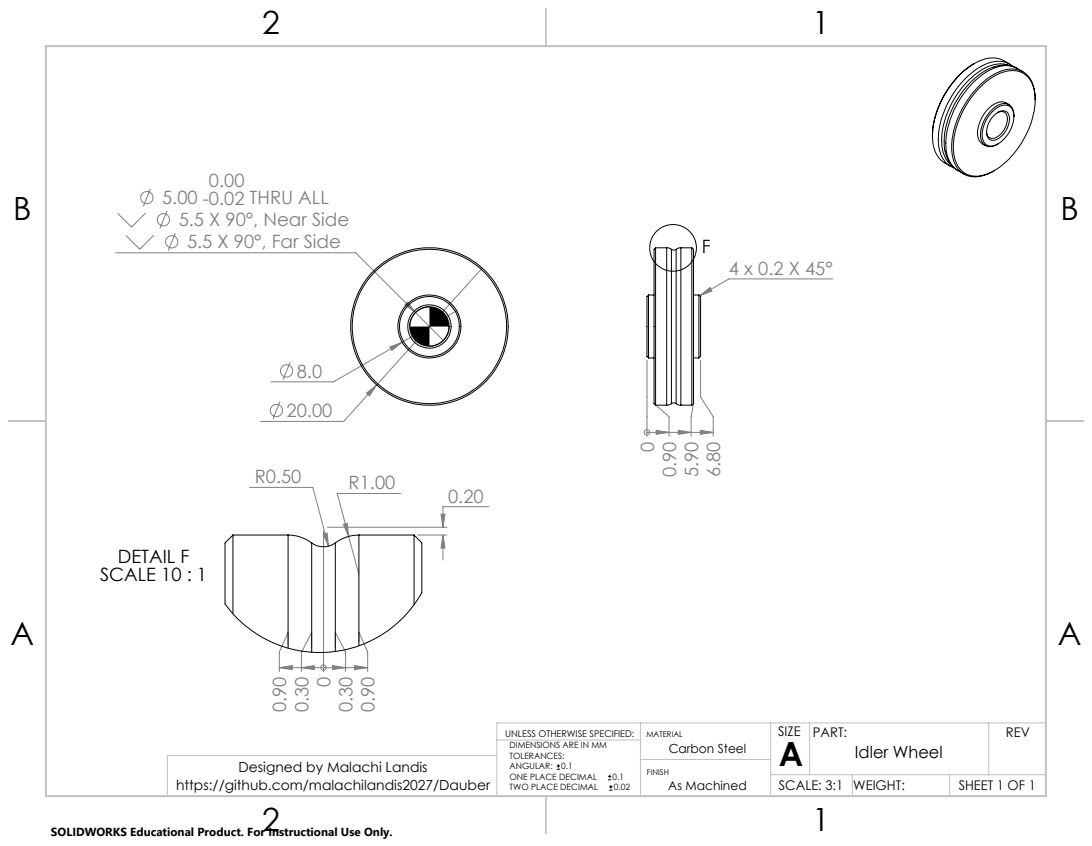
[picture p44: page 1]
5.00 - 0.02 THRU ALL 5.5 X 90°, Near Side 5.5 X 90°, Far Side; DETAIL F SCALE 10 : 1; Carbon Steel; Idler Wheel; SHEET 1 OF 1; SCALE: 3:1; WEIGHT:; As Machined; ONE PLACE DECIMAL; TWO PLACE DECIMAL

UNLESS OTHERWISE SPECIFIED:
DIMENSIONS ARE IN MM
TOLERANCES:
ANGULAR: 0.1

Designed by Malachi Landis

https://github.com/malachilandis2027/Dauber

SOLIDWORKS Educational Product. For Instructional Use Only.
