malachilandis2027/Dauber/V1/CAD/Drawing Exports/Motor Plate.pdf

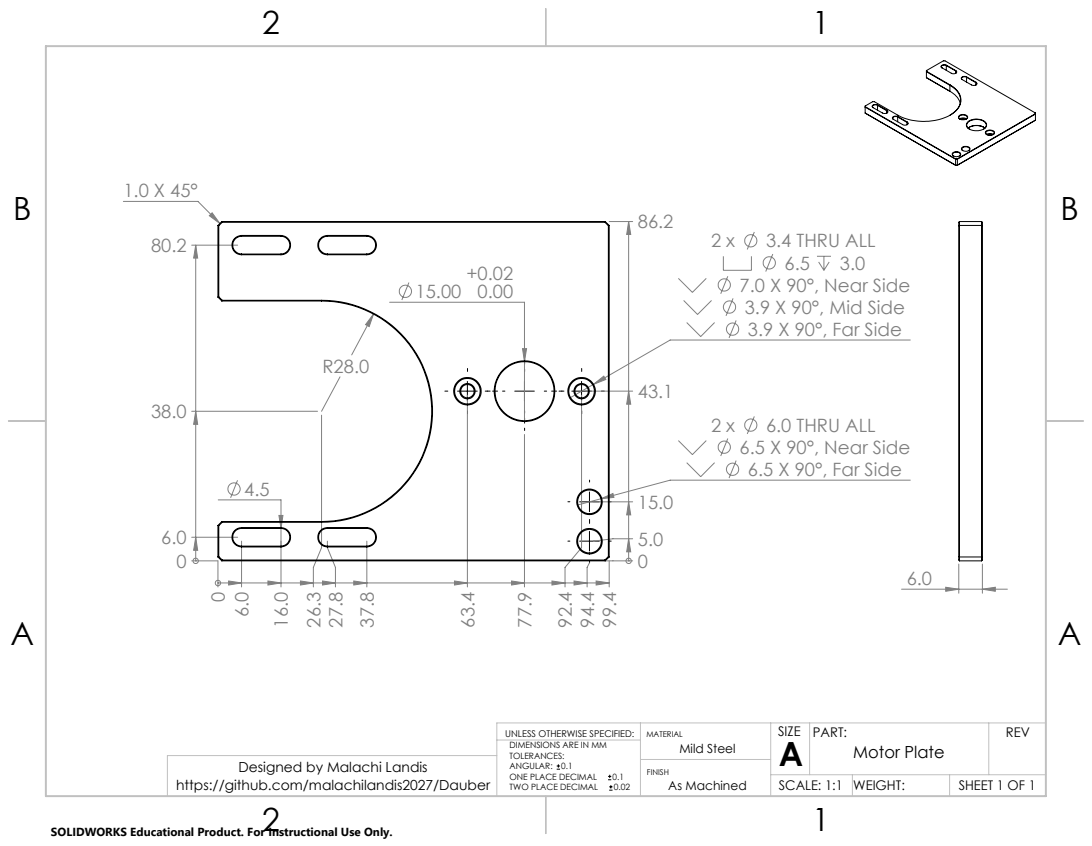
[picture p45: page 1]
3.4 THRU ALL; 6.5 3.0 7.0 X 90°, Near Side 3.9 X 90°, Mid Side 3.9 X 90°, Far Side; 6.0 THRU ALL; 6.5 X 90°, Near Side 6.5 X 90°, Far Side; Mild Steel; Motor Plate; SHEET 1 OF 1; SCALE: 1:1; WEIGHT:; As Machined; ONE PLACE DECIMAL; TWO PLACE DECIMAL

UNLESS OTHERWISE SPECIFIED:
DIMENSIONS ARE IN MM
TOLERANCES:
ANGULAR: 0.1

Designed by Malachi Landis

https://github.com/malachilandis2027/Dauber

SOLIDWORKS Educational Product. For Instructional Use Only.
