malachilandis2027/Dauber/V1/CAD/Drawing Exports/Pulley Tube.pdf

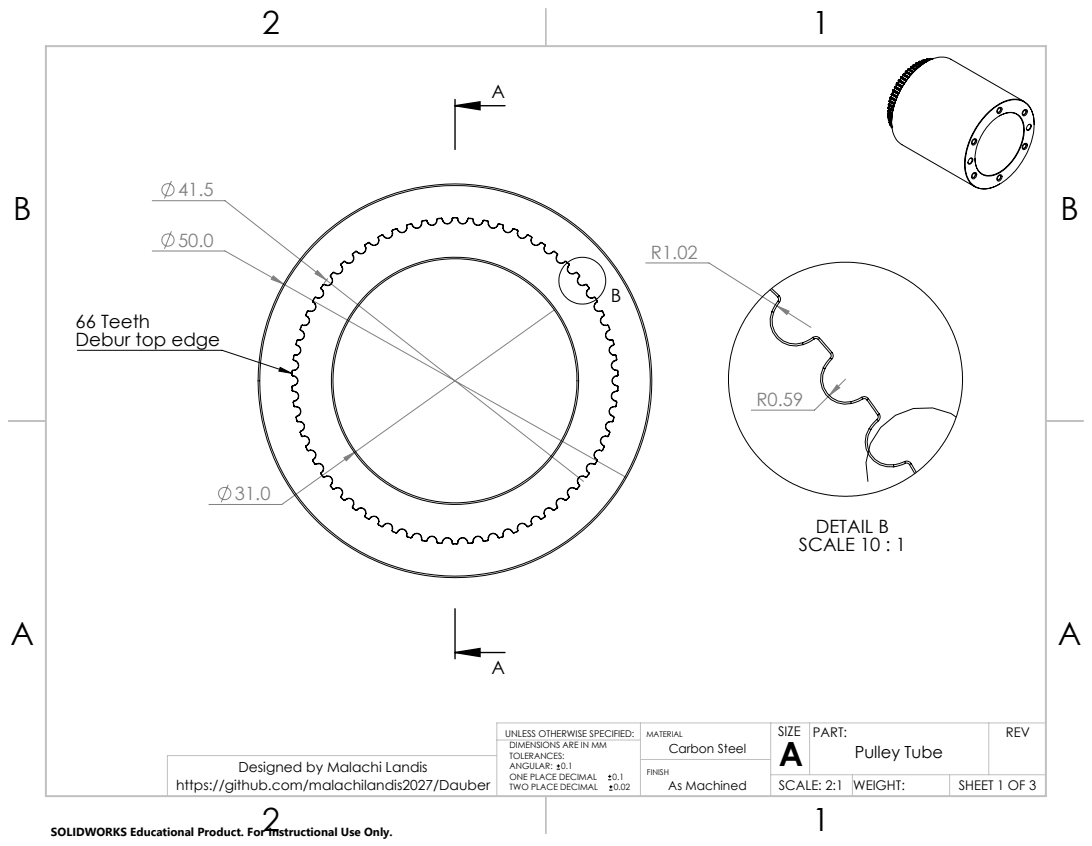
[picture p46: page 1]
DETAIL B SCALE 10 : 1; Carbon Steel; Pulley Tube; SHEET 1 OF 3; SCALE: 2:1; WEIGHT:; As Machined; ONE PLACE DECIMAL; TWO PLACE DECIMAL

66 Teeth
Debur top edge

UNLESS OTHERWISE SPECIFIED:
DIMENSIONS ARE IN MM
TOLERANCES:
ANGULAR: 0.1

Designed by Malachi Landis

https://github.com/malachilandis2027/Dauber

SOLIDWORKS Educational Product. For Instructional Use Only.

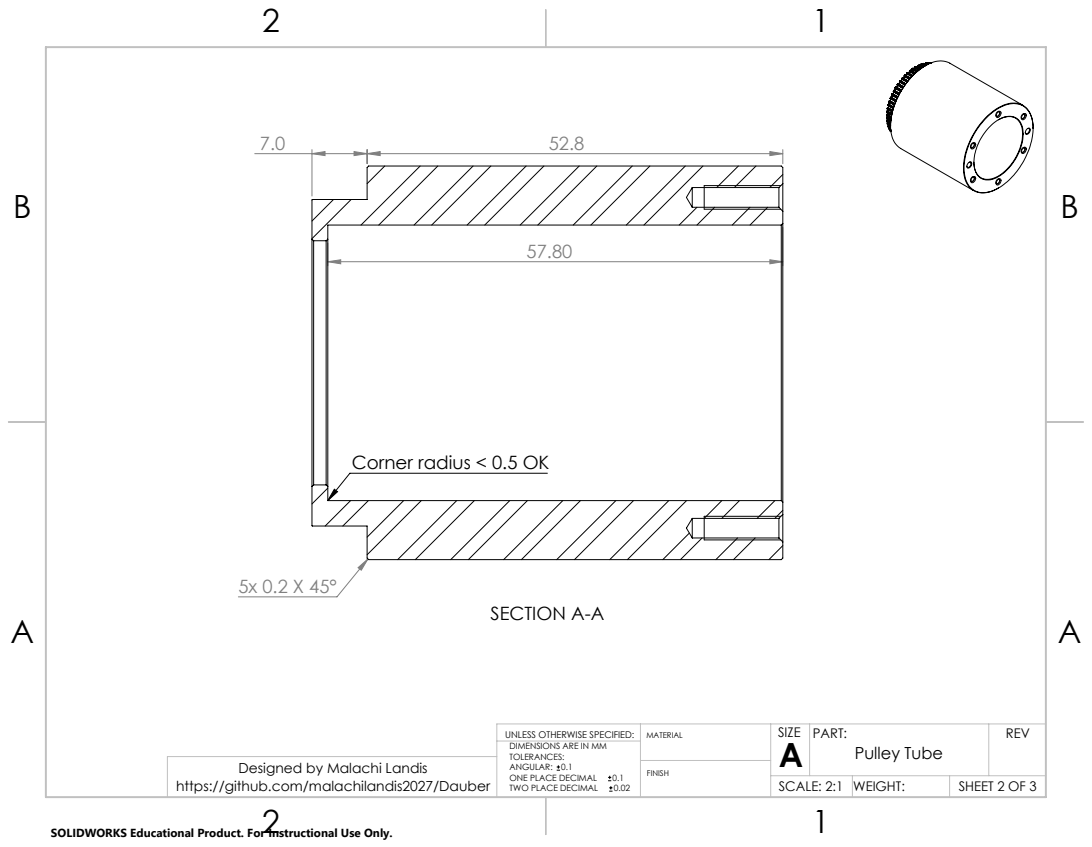
[picture p47: page 2]
SECTION A-A; Pulley Tube

Corner radius < 0.5 OK

UNLESS OTHERWISE SPECIFIED:
DIMENSIONS ARE IN MM
TOLERANCES:
ANGULAR: 0.1

Designed by Malachi Landis

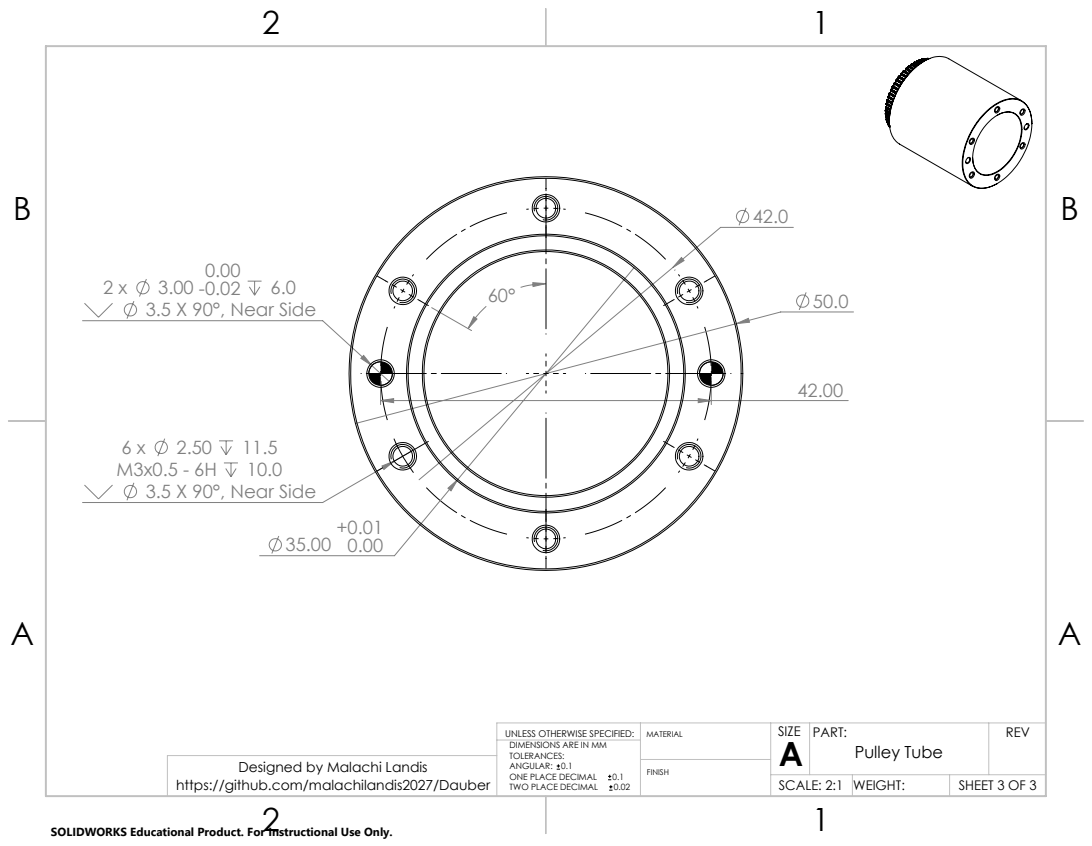
[picture p48: page 3]
M3x0.5 - 6H 10.0 3.5 X 90°, Near Side; 3.5 X 90°, Near Side; Pulley Tube

UNLESS OTHERWISE SPECIFIED:
DIMENSIONS ARE IN MM
TOLERANCES:
ANGULAR: 0.1

Designed by Malachi Landis
