malachilandis2027/Dauber/V1/CAD/Drawing Exports/Main Body.pdf

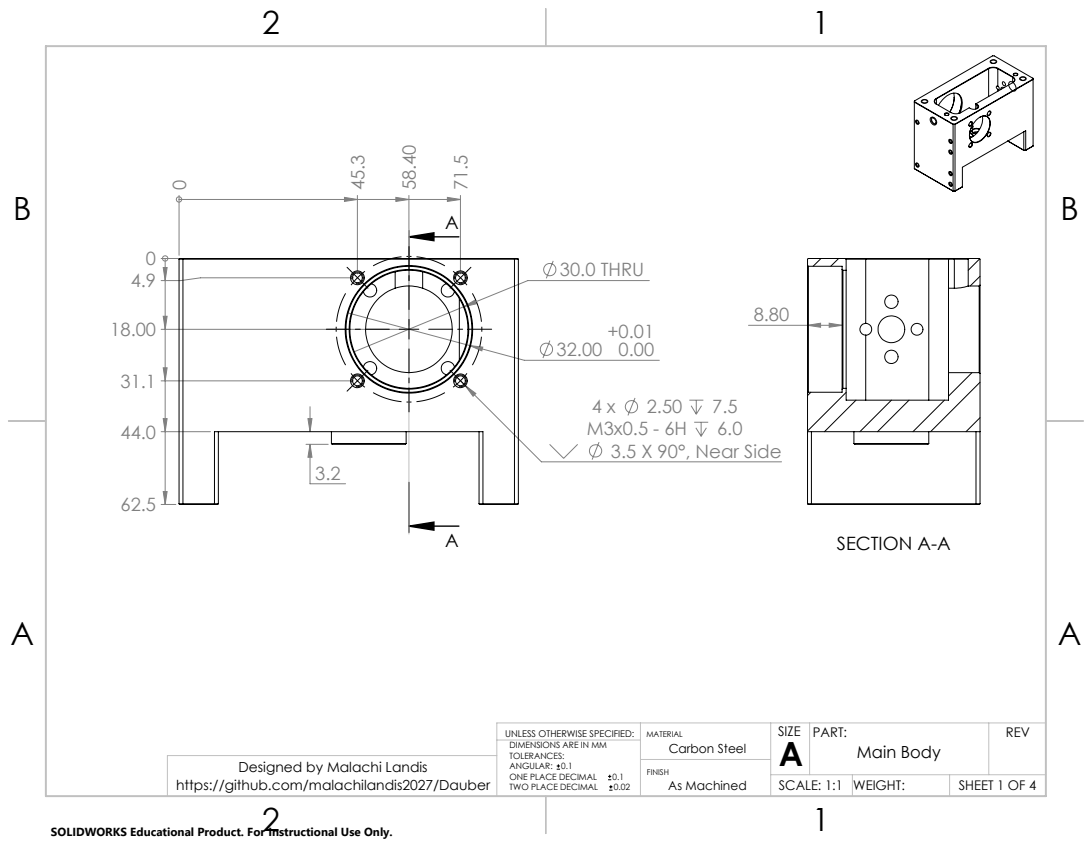
[picture p49: page 1]
30.0 THRU; M3x0.5 - 6H 6.0 3.5 X 90°, Near Side; SECTION A-A; Carbon Steel; Main Body; SHEET 1 OF 4; SCALE: 1:1; WEIGHT:; As Machined; ONE PLACE DECIMAL; TWO PLACE DECIMAL

UNLESS OTHERWISE SPECIFIED:
DIMENSIONS ARE IN MM
TOLERANCES:
ANGULAR: 0.1

Designed by Malachi Landis

https://github.com/malachilandis2027/Dauber

SOLIDWORKS Educational Product. For Instructional Use Only.

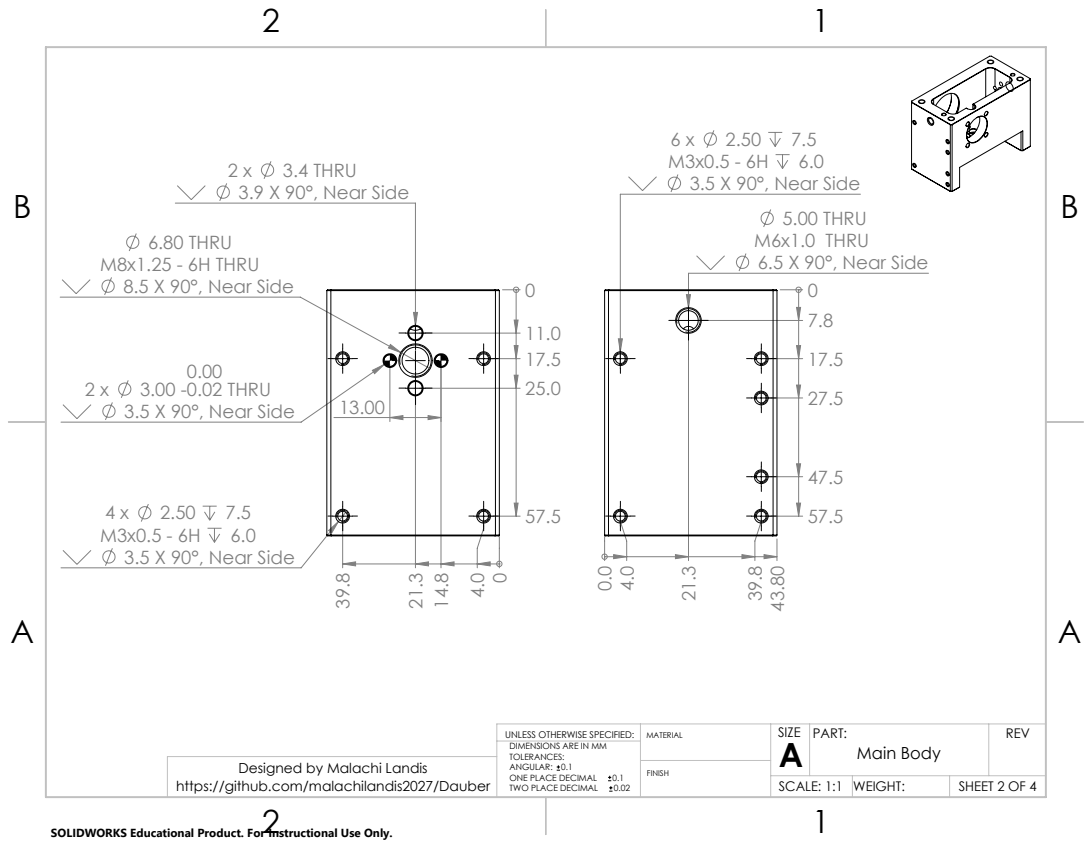
[picture p50: page 2]
5.00 THRU M6x1.0 THRU 6.5 X 90°, Near Side; M3x0.5 - 6H 6.0 3.5 X 90°, Near Side; 0.02 THRU 3.5 X 90°, Near Side; 3.4 THRU; 3.9 X 90°, Near Side; 6.80 THRU M8x1.25 - 6H THRU 8.5 X 90°, Near Side; Main Body

UNLESS OTHERWISE SPECIFIED:
DIMENSIONS ARE IN MM
TOLERANCES:
ANGULAR: 0.1

Designed by Malachi Landis

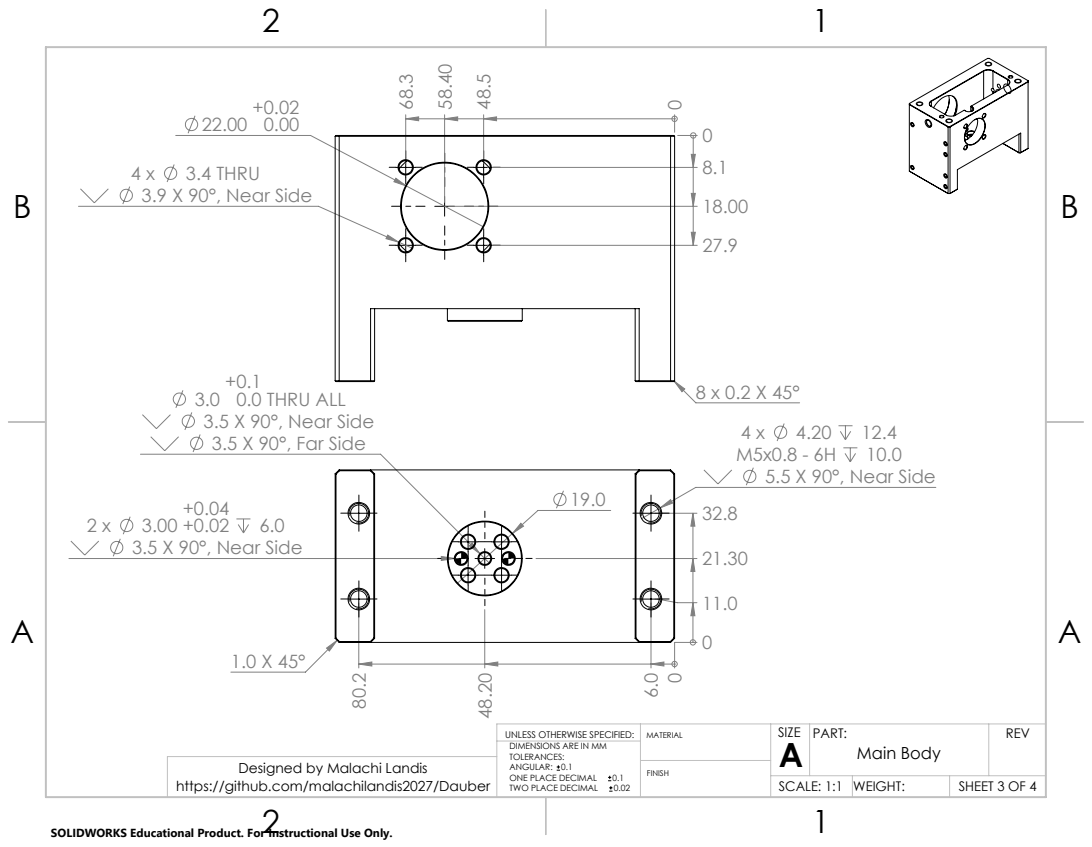
[picture p51: page 3]
3.4 THRU; 3.9 X 90°, Near Side; 0.02 6.0 3.5 X 90°, Near Side; M5x0.8 - 6H 10.0 5.5 X 90°, Near Side; 0.0 THRU ALL 3.5 X 90°, Near Side 3.5 X 90°, Far Side; Main Body

UNLESS OTHERWISE SPECIFIED:
DIMENSIONS ARE IN MM
TOLERANCES:
ANGULAR: 0.1

Designed by Malachi Landis

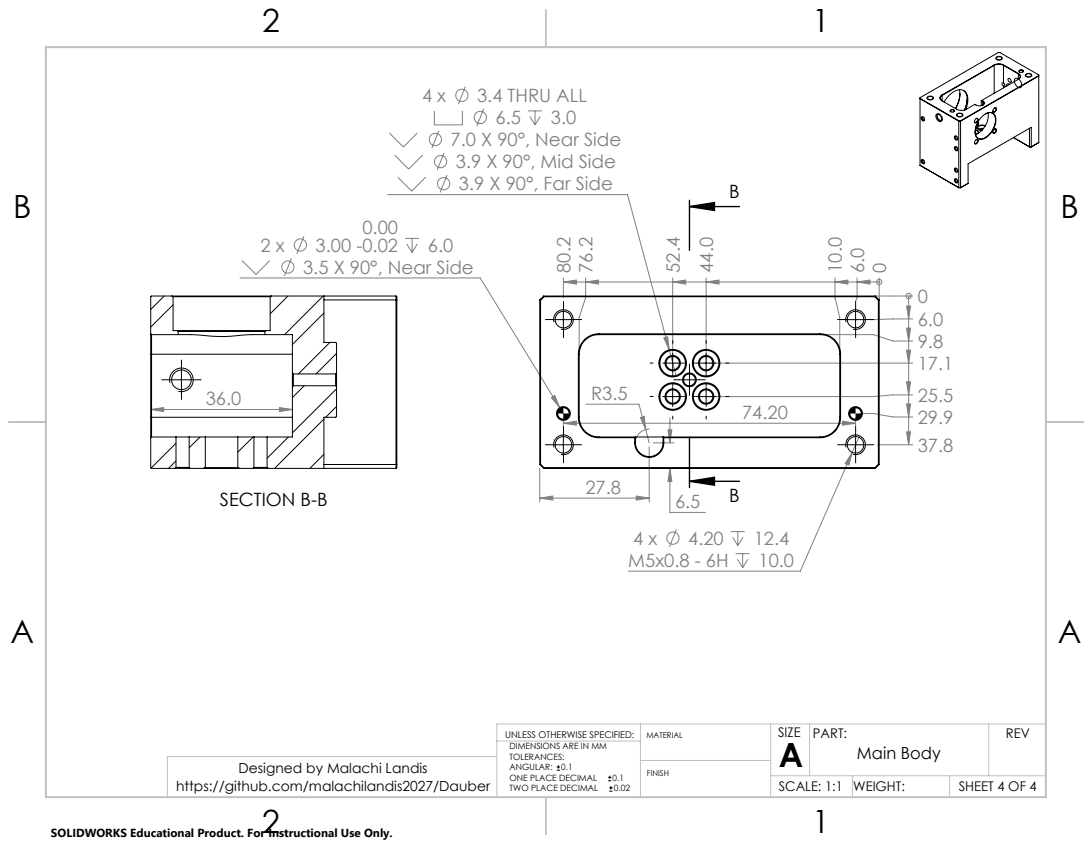
[picture p52: page 4]
3.4 THRU ALL; 6.5 3.0 7.0 X 90°, Near Side 3.9 X 90°, Mid Side 3.9 X 90°, Far Side; 0.02 6.0 3.5 X 90°, Near Side; SECTION B-B; Main Body

UNLESS OTHERWISE SPECIFIED:
DIMENSIONS ARE IN MM
TOLERANCES:
ANGULAR: 0.1

Designed by Malachi Landis
