malachilandis2027/Dauber/(commit log)

2023-06-21 initial upload of CAD
    [2385K43_Angular-Contact Ball Bearing.SLDPRT, 2385K44_Angular-Contact Ball Bearing.SLDPRT, Eccentric Tube.SLDPRT, Fixed Shaft.SLDPRT, Flexure Tube.SLDPRT, Master Sketch.SLDPRT, Pulley Tube.SLDPRT, Retaining Ring.SLDPRT]
2023-07-25 update to add arduino code, other misc CAD
    [Arduino Nano Breakout Standoff.SLDPRT, Arduino Nano Breakout Standoff.STL, BOM.xlsx, DC Motor Controller Standoff.SLDPRT, DC Motor Controller Standoff.STL, M3 Washer.SLDPRT, M3 Washer.STL, M4 Washer.SLDPRT]
2023-09-03 update arduino code
2024-03-31 Added V2
    [2333N145_Nickel-Plated Brass Push-to-Connect Fitting.SLDPRT, 2385K43_Angular-Contact Ball Bearing.SLDPRT, 2385K44_Angular-Contact Ball Bearing.SLDPRT, 3mm x 12mm Dowel Pin.SLDPRT, 3mm x 20mm Dowel Pin.SLDPRT, 3mm x 30mm Dowel Pin.SLDPRT, 5972K358_Ball Bearing.SLDPRT, 5mm x 20mm Dowel Pin.SLDPRT]
2024-05-09 Updated Drawing; Created New Drawing
    [Feed Clamp Nut.SLDDRW, Wire Guide.SLDDRW]
2024-05-09 Updated parts
    Updated Feed Clamp hole size; Wire Guide clearance.
    [Feed Clamp Nut.SLDPRT, Wire Guide.SLDPRT]
2024-09-06 update CAD
    [Feed Clamp Nut.SLDPRT, Feed Radial Bearing.SLDPRT, Feed Screw Left.SLDPRT, Feed Screw Right.SLDPRT, Feed Thrust Bearing.SLDPRT, Hex Standoff M4 25mm.SLDPRT, Motor Mount.SLDDRW, Motor Mount.SLDPRT]
2025-01-21 Enclosure stuff
    [Back Panel Assy.SLDASM, Back Panel.SLDPRT, Guide for Acorn.SLDPRT, Guide for Acorn.STL, Guide for Stepppers, Terminal Block.3mf, Guide for Stepppers, Terminal Block.SLDPRT, Guide for Stepppers, Terminal Block.STL, Guide for VFD, Acorn PSU.SLDPRT]
2025-01-21 Enclosure update
    [Guide for Steppers PSU, Terminal Block.SLDPRT, Guide for VFD, Acorn PSU.SLDPRT, Guide for VFD, Acorn PSU.STL, Top Panel.DXF, Top Panel.SLDDRW, Top Panel.SLDPRT]
2025-01-28 Spacers for feeder
    [Feeder Spacer 0,8mm.STL, Feeder Spacer 1,0mm.STL, Feeder Spacer 1,2mm.STL, Feeder Spacer 1,4mm.STL, Feeder Spacer 1,6mm.STL, Feeder Spacer.SLDPRT]
2025-02-11 New buildplate CAD
    [Lower Plate Top.DXF, Lower Plate.SLDDRW, Lower Plate.SLDPRT, Upper Plate Large.SLDPRT, Upper Plate Side.DXF, Upper Plate Small.SLDDRW, Upper Plate Small.SLDPRT, Upper Plate Underside.DXF]
2025-02-11 Fixed units on DXFs
    [Lower Plate Top.DXF, Upper Plate Side.DXF, Upper Plate Small.SLDPRT, Upper Plate Underside.DXF]
